eSpark-Consulting-Group/xponent-tech-sleep-enhancer-hw/README.md

# xponenttech-sleepenhancer-hardware
To develop a basic microphone PCB for the client
