eSpark-Consulting-Group/xponent-tech-sleep-enhancer-hw/Design Files/Xponent-tech/Deliverables/BOM/Client-BOM-Xponent-tech.xlsx

Sheet: 1 Board
 |  | Component list |  | Bill of Materials for Project [Xponent-tech]
 |  | Source Data From: |  | Xponent-tech
 |  | Project: |  | Xponent-tech
 |  | Variant: |  | None
# | Item Type | Designator | Description | Footprint | Manufacturer Part Number | Manufacturer | Value | Quantity | Total Cost (1 Boards) | Remarks
1 | Capacitor | C1, C2, C10, C13 | CAP CER 0.1UF 50V X7R 0603 | CAP-0603 | CL10B104KB8NNNL | Samsung | 0.1uF | 4 | $0.6500
2 | Capacitor | C3, C5, C17, C20 | CAP CER 1UF 50V X7R 0603 | Cap-0603 | UMK107AB7105KA-T | Taiyo Yuden | 1uF | 4 | $0.7000
3 | Capacitor | C4 | CAP CER 47PF 100V NPO 0603 | Cap-0603 | AC0603JRNPO0BN470 | Yageo | 47pF | 1 | $0.3000
4 | Capacitor | C6 | CAP CER 0.047UF 50V X8R 0603 | Cap-0603 | FN18X473K500PBG | TDK | 47nF | 1 | $0.3000
5 | Capacitor | C7 | CAP CER 4700PF 50V C0G/NPO 0603 | Cap-0603 | CC0603JRNPO9BN472 | Yageo | 4.7nF | 1 | $0.3000
6 | Capacitor | C8, C18 | CAP ALUM 10uF 25V SMD | Custom | RVT1E100M0405 | ROQANG | 10uF | 2 | $1.2580
7 | Capacitor | C9 | CAP CER 0.022UF 100V X7R 0603 | Cap-0603 | CC0603KRX7R0BB223 | TDK | 22nF | 1 | $0.3500
8 | Capacitor | C11 | 100V 4.2nF X7R ±10% 0402 Multilayer Ceramic Capacitors MLCC - SMD/SMT ROHS | Cap-0402 | GCM155R72A472KA01D | Murata Electronics | 4.2nF | 1 | $0.2500
9 | Capacitor | C12 | CAP CER 1200PF 25V X7R 0402 | Cap-0402 | 0402B122K250CT | KEMET | 1.2nF | 1 | $0.2500
10 | Capacitor | C14, C15 | 50V 100nF C0G ±1% 1206 Multilayer Ceramic Capacitors MLCC - SMD/SMT ROHS | Cap-1206 | GRM31C5C1H104FA01L | Murata Electronics | 0.1uF | 2 | $0.4000
11 | Capacitor | C16 | 50V 200nF ±10% 0805 Multilayer Ceramic Capacitors MLCC - SMD/SMT ROHS | Cap-0805 | NL0805B204K500CPBN | HUI JU | 0.2uF | 1 | $0.2500
12 | Capacitor | C19 | CAP CER 4.7UF 50V X7R 1206 | Cap-1206 | GRM31CR61E476ME44L | TDK | 4.7uF | 1 | $0.3000
13 | Capacitor | C21 | CAP CER 33PF 25V C0G/NP0 0402 | Cap-0402 | 0402N330K250CT | Murata | 33pF | 1 | $0.2000
14 | Capacitor | C22 | CAP, 2.2µF, 35V, 10%, X5R, 0603 | Cap-0603 | GRM188R6YA225KA12D | Murata | 2.2uF | 1 | $0.3500
15 | Header | J1 | KK 254 Breakaway Header, Vertical, 2 Circuits, Tin (Sn) Plating, Mating Pin Length 6.09mm | HDR1X2_ | 22-28-4020 | Molex | - | 1 | $0.3000
16 | Header | J2 | 3A Straight Square Pins -40℃~+105℃ 3 2.54mm Black 1x3P Plugin,P=2.54mm Pin Headers ROHS | HDR1X3_ | C49257 | BOOMELE | - | 1 | $0.3500
17 | Microphone | MK1 | 1.5V~3.6V Omnidirectional 120uA -42dB 400Ω 59dB SMD-4P,1.9x2.8mm MEMS Microphones ROHS | Custom | ZTS6117 | Zilltek | - | 1 | $1.7200
18 | Potentiometer | R1, R10 | Trimmer, Cermet, Rest 100 Kilohms, PCB, 25 Turns, Pwr-Rtg 0.5W, 3296 Series | Custom | 3296W-1-104 | BOCHEN(Chengdu Guosheng Tech) | 100k | 2 | $2.5800
19 | Resistor | R2, R3, R4, R7, R8, R9, R48, R52, R65, R66, R68, R69, R70 | RES SMD 10K OHM 0.1% 1/10W 0603 | Res-0603 | RT0603BRD0710KL | Yageo | 10K | 13 | $0.8800
20 | Potentiometer | R5 | ±25% 500kΩ SMD Variable Resistors/Potentiometers ROHS | Custom | VG039NCHXTB504 | HDK | 500k | 1 | $0.7200
21 | Resistor | R6, R42, R43, R58 | RES SMD 1K OHM 0.1% 1/10W 0603 | Res-0603 | RT0603BRD071KL | Yageo | 1K | 4 | $0.4700
22 | Resistor | R11, R12 | RES SMD 3.3K OHM 0.1% 1/10W 0603 | Res-0603 | RT0603BRD073K3L | Yageo | 3.3k | 2 | $0.4000
23 | Resistor | R13 | RES SMD 22K OHM 0.1% 1/10W 0603 | Res-0603 | RT0603BRD0722KL | Yageo | 22K | 1 | $0.2500
24 | Potentiometer | R14 | Res Cermet Trimmer 500K Ohm 10% 1/2W 25(Elec)Turn | Custom | 3296W-1-504 | BOCHEN(Chengdu Guosheng Tech) | 500k | 1 | $2.4250
25 | Resistor | R15, R16 | RES SMD 1.8K OHM 0.1% 1/10W 0603 | Res-0603 | RT0603BRD071K8L | Yageo | 1.8K | 2 | $0.4500
26 | Resistor | R17 | RES SMD 270 OHM 0.1% 1/10W 0603 | Res-0603 | RT0603BRE07270RL | Yageo | 270R | 1 | $0.3000
27 | Resistor | R18, R19 | ±1% 80kΩ 0603 Chip Resistor - Surface Mount ROHS | Res-0603 | ARG03FTC8002N | Viking Tech | 80K | 2 | $0.3800
28 | Resistor | R20, R21, R49 | ±0.1% 40kΩ 0805 Chip Resistor - Surface Mount ROHS | RES-0805 | AR05BTC4002 | Viking Tech | 40K | 3 | $0.5800
29 | Resistor | R22, R23 | ±25ppm/℃ ±0.1% 27kΩ 0402 Chip Resistor - Surface Mount ROHS | Res-0402 | ARG02BTC2702 | Viking Tech | 27K | 2 | $0.6000
30 | Resistor | R24, R25, R50 | 100mW ±25ppm/℃ ±0.1% 20kΩ 0603 Chip Resistor - Surface Mount ROHS | Res-0603 | AR03BTCX2002 | Viking Tech | 20K | 3 | $0.7000
31 | Resistor | R26, R27 | RES 16K OHM 0.5% 1/10W 0603 | Res-0603 | RC0603DR-0716KL | Yageo | 16K | 2 | $0.3700
32 | Resistor | R28, R29, R53 | RES SMD 8.2K OHM 0.1% 1/10W 0603 | Res-0603 | RT0603BRD078K2L | Yageo | 8.2K | 3 | $0.4900
33 | Resistor | R30, R31, R55 | RES 4.02K OHM 1% 1/16W 0402 | Res-0402 | RC0402FR-074K02L | Yageo | 4.02K | 3 | $0.7000
34 | Resistor | R32, R33 | RES 2.7K OHM 1% 1/10W 0603 | Res-0603 | RC0603FR-072K7L | Yageo | 2.7K | 2 | $0.2500
35 | Resistor | R34, R35, R56 | 100mW ±25ppm/℃ ±0.1% 2kΩ 0603 Chip Resistor - Surface Mount ROHS | Res-0603 | AR03BTCX2001 | Viking Tech | 2K | 3 | $0.4500
36 | Resistor | R36, R37 | RES SMD 1.6K OHM 0.1% 1/16W 0402 | Res-0402 | RT0402BRD071K6L | Yageo | 1.6K | 2 | $0.3600
37 | Resistor | R38, R39, R57 | 100mW ±25ppm/℃ ±0.1% 1.3kΩ 0603 Chip Resistor - Surface Mount ROHS | Res-0603 | AR03BTCX1301 | Viking Tech | 1.3K | 3 | $0.9000
38 | Resistor | R40, R41 | RES SMD 1.1K OHM 0.1% 1/10W 0603 | Res-0603 | RT0603BRD071K1L | Yageo | 1.1K | 2 | $0.5500
39 | Resistor | R44, R45 | 125mW Thin Film Resistor 150V ±25ppm/℃ ±0.1% -55℃~+155℃ 900Ω 0805 Chip Resistor - Surface Mount ROHS | RES-0805 | ARG05BTC9000N | Viking Tech | 900R | 2 | $0.6500
40 | Resistor | R46, R47, R59 | RES SMD 806 OHM 0.1% 1/16W 0402 | Res-0402 | RT0402BRD07806RL | Yageo | 806R | 3 | $0.8500
41 | Resistor | R51 | RES SMD 13.3KOHM 0.1% 1/10W 0603 | Res-0603 | RT0603BRD0713K3L | Yageo | 13.3K | 1 | $0.2000
42 | Resistor | R54 | 125mW Thick Film Resistors 150V ±100ppm/℃ ±1% -55℃~+155℃ 98kΩ 0805 Chip Resistor - Surface Mount ROHS | RES-0805 | FRC0805F9802TS | FOJAN | 98K | 1 | $0.4000
43 | Resistor | R60 | RES SMD 649 OHM 0.1% 1/8W 0805 | RES-0805 | RT0805BRD07649RL | Yageo | 649R | 1 | $0.3000
44 | Resistor | R61 | 62.5mW Thin Film Resistor 50V ±25ppm/℃ ±0.1% -55℃~+155℃ 549Ω 0402 Chip Resistor - Surface Mount ROHS | Res-0402 | ARG02BTC5490 | Viking Tech | 549R | 1 | $0.2500
45 | Resistor | R62 | 125mW Thin Film Resistor 150V ±25ppm/℃ ±0.1% -55℃~+155℃ 500Ω 0805 Chip Resistor - Surface Mount ROHS | RES-0805 | ARG05BTC5000 | Viking Tech | 500R | 1 | $0.2500
46 | Resistor | R63 | RES SMD 453 OHM 0.1% 1/16W 0402 | Res-0402 | RT0402BRD07453RL | Yageo | 453R | 1 | $0.2500
47 | Resistor | R64 | 100mW Thin Film Resistor 75V ±25ppm/℃ ±0.1% -55℃~+155℃ 402Ω 0603 Chip Resistor - Surface Mount ROHS | Res-0603 | ARG03BTC4020 | Viking Tech | 402R | 1 | $0.2500
48 | Potentiometer | R67 | TRIMMER 100K OHM 0.1W J LEAD TOP | Custom | TC33X-2-104E | Bourns | 100k | 1 | $0.8000
49 | Resistor | R71, R72 | RES SMD 47K OHM 0.1% 1/10W 0603 | Res-0603 | RT0603BRD0747KL | Yageo | 47K | 2 | $0.4200
50 | Solder Bridge | ~~SB1, SB2~~ | ~~Solder Bridge ON~~ | ~~Custom~~ | ~~Solder Bridge~~ | ~~-~~ | ~~-~~ | ~~2~~ | ~~-~~
51 | Switch | SW1, SW2, SW3, SW4, SW5, SW6, SW7, SW8, SW9 | Gull Wing SPST 24V 25mA Black -20℃~+70℃ 3000 Flat dial, raised type 2.54mm 5 SMD-10P,6x12.6mm DIP Switches ROHS | Custom | DSIC05LS-P | XKB Connectivity | - | 9 | $13.6000
52 | IC | U1, U2, U3 | General Purpose Amplifier 2 Circuit 8-SO | SOIC-8 | LM2904DT | STMicroelectronics | - | 3 | $3.8000
 |  |  |  |  |  | Total Component Cost |  |  | $45.05

Sheet: 2 Boards
 |  | Component list |  | Bill of Materials for Project [Xponent-tech]
 |  | Source Data From: |  | Xponent-tech
 |  | Project: |  | Xponent-tech
 |  | Variant: |  | None
# | Item Type | Designator | Description | Footprint | Manufacturer Part Number | Manufacturer | Value | Quantity Per Board | Quantity (2 Boards) | Total Cost (2 Boards) | Remarks
1 | Capacitor | C1, C2, C10, C13 | CAP CER 0.1UF 50V X7R 0603 | CAP-0603 | CL10B104KB8NNNL | Samsung | 0.1uF | 4 | 8 | $0.8000
2 | Capacitor | C3, C5, C17, C20 | CAP CER 1UF 50V X7R 0603 | Cap-0603 | UMK107AB7105KA-T | Taiyo Yuden | 1uF | 4 | 8 | $0.7500
3 | Capacitor | C4 | CAP CER 47PF 100V NPO 0603 | Cap-0603 | AC0603JRNPO0BN470 | Yageo | 47pF | 1 | 2 | $0.3000
4 | Capacitor | C6 | CAP CER 0.047UF 50V X8R 0603 | Cap-0603 | FN18X473K500PBG | TDK | 47nF | 1 | 2 | $0.3000
5 | Capacitor | C7 | CAP CER 4700PF 50V C0G/NPO 0603 | Cap-0603 | CC0603JRNPO9BN472 | Yageo | 4.7nF | 1 | 2 | $0.3000
6 | Capacitor | C8, C18 | CAP ALUM 10uF 25V SMD | Custom | RVT1E100M0405 | ROQANG | 10uF | 2 | 4 | $2.4500
7 | Capacitor | C9 | CAP CER 0.022UF 100V X7R 0603 | Cap-0603 | CC0603KRX7R0BB223 | TDK | 22nF | 1 | 2 | $0.3500
8 | Capacitor | C11 | 100V 4.2nF X7R ±10% 0402 Multilayer Ceramic Capacitors MLCC - SMD/SMT ROHS | Cap-0402 | GCM155R72A472KA01D | Murata Electronics | 4.2nF | 1 | 2 | $0.3500
9 | Capacitor | C12 | CAP CER 1200PF 25V X7R 0402 | Cap-0402 | 0402B122K250CT | KEMET | 1.2nF | 1 | 2 | $0.3500
10 | Capacitor | C14, C15 | 50V 100nF C0G ±1% 1206 Multilayer Ceramic Capacitors MLCC - SMD/SMT ROHS | Cap-1206 | GRM31C5C1H104FA01L | Murata Electronics | 0.1uF | 2 | 4 | $0.6500
11 | Capacitor | C16 | 50V 200nF ±10% 0805 Multilayer Ceramic Capacitors MLCC - SMD/SMT ROHS | Cap-0805 | NL0805B204K500CPBN | HUI JU | 0.2uF | 1 | 2 | $0.2500
12 | Capacitor | C19 | CAP CER 4.7UF 50V X7R 1206 | Cap-1206 | GRM31CR61E476ME44L | TDK | 4.7uF | 1 | 2 | $0.3000
13 | Capacitor | C21 | CAP CER 33PF 25V C0G/NP0 0402 | Cap-0402 | 0402N330K250CT | Murata | 33pF | 1 | 2 | $0.3000
14 | Capacitor | C22 | CAP, 2.2µF, 35V, 10%, X5R, 0603 | Cap-0603 | GRM188R6YA225KA12D | Murata | 2.2uF | 1 | 2 | $0.4000
15 | Header | J1 | KK 254 Breakaway Header, Vertical, 2 Circuits, Tin (Sn) Plating, Mating Pin Length 6.09mm | HDR1X2_ | 22-28-4020 | Molex | - | 1 | 2 | $0.4800
16 | Header | J2 | 3A Straight Square Pins -40℃~+105℃ 3 2.54mm Black 1x3P Plugin,P=2.54mm Pin Headers ROHS | HDR1X3_ | C49257 | BOOMELE | - | 1 | 2 | $0.5200
17 | Microphone | MK1 | 1.5V~3.6V Omnidirectional 120uA -42dB 400Ω 59dB SMD-4P,1.9x2.8mm MEMS Microphones ROHS | Custom | ZTS6117 | Zilltek | - | 1 | 2 | $2.3200
18 | Potentiometer | R1, R10 | Trimmer, Cermet, Rest 100 Kilohms, PCB, 25 Turns, Pwr-Rtg 0.5W, 3296 Series | Custom | 3296W-1-104 | BOCHEN(Chengdu Guosheng Tech) | 100k | 2 | 4 | $3.8000
19 | Resistor | R2, R3, R4, R7, R8, R9, R48, R52, R65, R66, R68, R69, R70 | RES SMD 10K OHM 0.1% 1/10W 0603 | Res-0603 | RT0603BRD0710KL | Yageo | 10K | 13 | 26 | $1.2000
20 | Potentiometer | R5 | ±25% 500kΩ SMD Variable Resistors/Potentiometers ROHS | Custom | VG039NCHXTB504 | HDK | 500k | 1 | 2 | $0.3500
21 | Resistor | R6, R42, R43, R58 | RES SMD 1K OHM 0.1% 1/10W 0603 | Res-0603 | RT0603BRD071KL | Yageo | 1K | 4 | 8 | $0.6500
22 | Resistor | R11, R12 | RES SMD 3.3K OHM 0.1% 1/10W 0603 | Res-0603 | RT0603BRD073K3L | Yageo | 3.3k | 2 | 4 | $0.4200
23 | Resistor | R13 | RES SMD 22K OHM 0.1% 1/10W 0603 | Res-0603 | RT0603BRD0722KL | Yageo | 22K | 1 | 2 | $0.4000
24 | Potentiometer | R14 | Res Cermet Trimmer 500K Ohm 10% 1/2W 25(Elec)Turn | Custom | 3296W-1-504 | BOCHEN(Chengdu Guosheng Tech) | 500k | 1 | 2 | $3.7600
25 | Resistor | R15, R16 | RES SMD 1.8K OHM 0.1% 1/10W 0603 | Res-0603 | RT0603BRD071K8L | Yageo | 1.8K | 2 | 4 | $0.7000
26 | Resistor | R17 | RES SMD 270 OHM 0.1% 1/10W 0603 | Res-0603 | RT0603BRE07270RL | Yageo | 270R | 1 | 2 | $0.4800
27 | Resistor | R18, R19 | ±1% 80kΩ 0603 Chip Resistor - Surface Mount ROHS | Res-0603 | ARG03FTC8002N | Viking Tech | 80K | 2 | 4 | $0.9000
28 | Resistor | R20, R21, R49 | ±0.1% 40kΩ 0805 Chip Resistor - Surface Mount ROHS | RES-0805 | AR05BTC4002 | Viking Tech | 40K | 3 | 6 | $0.7500
29 | Resistor | R22, R23 | ±25ppm/℃ ±0.1% 27kΩ 0402 Chip Resistor - Surface Mount ROHS | Res-0402 | ARG02BTC2702 | Viking Tech | 27K | 2 | 4 | $0.5600
30 | Resistor | R24, R25, R50 | 100mW ±25ppm/℃ ±0.1% 20kΩ 0603 Chip Resistor - Surface Mount ROHS | Res-0603 | AR03BTCX2002 | Viking Tech | 20K | 3 | 6 | $0.6700
31 | Resistor | R26, R27 | RES 16K OHM 0.5% 1/10W 0603 | Res-0603 | RC0603DR-0716KL | Yageo | 16K | 2 | 4 | $0.3800
32 | Resistor | R28, R29, R53 | RES SMD 8.2K OHM 0.1% 1/10W 0603 | Res-0603 | RT0603BRD078K2L | Yageo | 8.2K | 3 | 6 | $0.7800
33 | Resistor | R30, R31, R55 | RES 4.02K OHM 1% 1/16W 0402 | Res-0402 | RC0402FR-074K02L | Yageo | 4.02K | 3 | 6 | $0.6900
34 | Resistor | R32, R33 | RES 2.7K OHM 1% 1/10W 0603 | Res-0603 | RC0603FR-072K7L | Yageo | 2.7K | 2 | 4 | $0.6000
35 | Resistor | R34, R35, R56 | 100mW ±25ppm/℃ ±0.1% 2kΩ 0603 Chip Resistor - Surface Mount ROHS | Res-0603 | AR03BTCX2001 | Viking Tech | 2K | 3 | 6 | $0.7000
36 | Resistor | R36, R37 | RES SMD 1.6K OHM 0.1% 1/16W 0402 | Res-0402 | RT0402BRD071K6L | Yageo | 1.6K | 2 | 4 | $0.4500
37 | Resistor | R38, R39, R57 | 100mW ±25ppm/℃ ±0.1% 1.3kΩ 0603 Chip Resistor - Surface Mount ROHS | Res-0603 | AR03BTCX1301 | Viking Tech | 1.3K | 3 | 6 | $0.5000
38 | Resistor | R40, R41 | RES SMD 1.1K OHM 0.1% 1/10W 0603 | Res-0603 | RT0603BRD071K1L | Yageo | 1.1K | 2 | 4 | $0.4700
39 | Resistor | R44, R45 | 125mW Thin Film Resistor 150V ±25ppm/℃ ±0.1% -55℃~+155℃ 900Ω 0805 Chip Resistor - Surface Mount ROHS | RES-0805 | ARG05BTC9000N | Viking Tech | 900R | 2 | 4 | $0.6000
40 | Resistor | R46, R47, R59 | RES SMD 806 OHM 0.1% 1/16W 0402 | Res-0402 | RT0402BRD07806RL | Yageo | 806R | 3 | 6 | $0.8000
41 | Resistor | R51 | RES SMD 13.3KOHM 0.1% 1/10W 0603 | Res-0603 | RT0603BRD0713K3L | Yageo | 13.3K | 1 | 2 | $0.4500
42 | Resistor | R54 | 125mW Thick Film Resistors 150V ±100ppm/℃ ±1% -55℃~+155℃ 98kΩ 0805 Chip Resistor - Surface Mount ROHS | RES-0805 | FRC0805F9802TS | FOJAN | 98K | 1 | 2 | $0.3700
43 | Resistor | R60 | RES SMD 649 OHM 0.1% 1/8W 0805 | RES-0805 | RT0805BRD07649RL | Yageo | 649R | 1 | 2 | $0.4000
44 | Resistor | R61 | 62.5mW Thin Film Resistor 50V ±25ppm/℃ ±0.1% -55℃~+155℃ 549Ω 0402 Chip Resistor - Surface Mount ROHS | Res-0402 | ARG02BTC5490 | Viking Tech | 549R | 1 | 2 | $0.3300
45 | Resistor | R62 | 125mW Thin Film Resistor 150V ±25ppm/℃ ±0.1% -55℃~+155℃ 500Ω 0805 Chip Resistor - Surface Mount ROHS | RES-0805 | ARG05BTC5000 | Viking Tech | 500R | 1 | 2 | $0.3000
46 | Resistor | R63 | RES SMD 453 OHM 0.1% 1/16W 0402 | Res-0402 | RT0402BRD07453RL | Yageo | 453R | 1 | 2 | $0.2500
47 | Resistor | R64 | 100mW Thin Film Resistor 75V ±25ppm/℃ ±0.1% -55℃~+155℃ 402Ω 0603 Chip Resistor - Surface Mount ROHS | Res-0603 | ARG03BTC4020 | Viking Tech | 402R | 1 | 2 | $0.4400
48 | Potentiometer | R67 | TRIMMER 100K OHM 0.1W J LEAD TOP | Custom | TC33X-2-104E | Bourns | 100k | 1 | 2 | $0.1300
49 | Resistor | R71, R72 | RES SMD 47K OHM 0.1% 1/10W 0603 | Res-0603 | RT0603BRD0747KL | Yageo | 47K | 2 | 4 | $0.4500
50 | Solder Bridge | ~~SB1, SB2~~ | ~~Solder Bridge ON~~ | ~~Custom~~ | ~~Solder Bridge~~ | ~~-~~ | ~~-~~ | ~~2~~ | 4 | -
51 | Switch | SW1, SW2, SW3, SW4, SW5, SW6, SW7, SW8, SW9 | Gull Wing SPST 24V 25mA Black -20℃~+70℃ 3000 Flat dial, raised type 2.54mm 5 SMD-10P,6x12.6mm DIP Switches ROHS | Custom | DSIC05LS-P | XKB Connectivity | - | 9 | 18 | $15.7000
52 | IC | U1, U2, U3 | General Purpose Amplifier 2 Circuit 8-SO | SOIC-8 | LM2904DT | STMicroelectronics | - | 3 | 6 | $5.4000
 |  |  |  |  |  |  | Total Component Cost |  |  | $56.00
 |  |  |  |  |  |  | Single Board Cost |  |  | $28.00

Sheet: 5 Boards
 |  | Component list |  | Bill of Materials for Project [Xponent-tech]
 |  | Source Data From: |  | Xponent-tech
 |  | Project: |  | Xponent-tech
 |  | Variant: |  | None
# | Item Type | Designator | Description | Footprint | Manufacturer Part Number | Manufacturer | Value | Quantity Per Board | Quantity (5 Boards) | Total Cost(5 Boards) | Remarks
1 | Capacitor | C1, C2, C10, C13 | CAP CER 0.1UF 50V X7R 0603 | CAP-0603 | CL10B104KB8NNNL | Samsung | 0.1uF | 4 | 20 | $0.8800
2 | Capacitor | C3, C5, C17, C20 | CAP CER 1UF 50V X7R 0603 | Cap-0603 | UMK107AB7105KA-T | Taiyo Yuden | 1uF | 4 | 20 | $0.7800
3 | Capacitor | C4 | CAP CER 47PF 100V NPO 0603 | Cap-0603 | AC0603JRNPO0BN470 | Yageo | 47pF | 1 | 5 | $0.6500
4 | Capacitor | C6 | CAP CER 0.047UF 50V X8R 0603 | Cap-0603 | FN18X473K500PBG | TDK | 47nF | 1 | 5 | $0.7000
5 | Capacitor | C7 | CAP CER 4700PF 50V C0G/NPO 0603 | Cap-0603 | CC0603JRNPO9BN472 | Yageo | 4.7nF | 1 | 5 | $0.6900
6 | Capacitor | C8, C18 | CAP ALUM 10uF 25V SMD | Custom | RVT1E100M0405 | ROQANG | 10uF | 2 | 10 | $4.7000
7 | Capacitor | C9 | CAP CER 0.022UF 100V X7R 0603 | Cap-0603 | CC0603KRX7R0BB223 | TDK | 22nF | 1 | 5 | $0.7000
8 | Capacitor | C11 | 100V 4.2nF X7R ±10% 0402 Multilayer Ceramic Capacitors MLCC - SMD/SMT ROHS | Cap-0402 | GCM155R72A472KA01D | Murata Electronics | 4.2nF | 1 | 5 | $0.5600
9 | Capacitor | C12 | CAP CER 1200PF 25V X7R 0402 | Cap-0402 | 0402B122K250CT | KEMET | 1.2nF | 1 | 5 | $0.7700
10 | Capacitor | C14, C15 | 50V 100nF C0G ±1% 1206 Multilayer Ceramic Capacitors MLCC - SMD/SMT ROHS | Cap-1206 | GRM31C5C1H104FA01L | Murata Electronics | 0.1uF | 2 | 10 | $0.6600
11 | Capacitor | C16 | 50V 200nF ±10% 0805 Multilayer Ceramic Capacitors MLCC - SMD/SMT ROHS | Cap-0805 | NL0805B204K500CPBN | HUI JU | 0.2uF | 1 | 5 | $0.7800
12 | Capacitor | C19 | CAP CER 4.7UF 50V X7R 1206 | Cap-1206 | GRM31CR61E476ME44L | TDK | 4.7uF | 1 | 5 | $0.6750
13 | Capacitor | C21 | CAP CER 33PF 25V C0G/NP0 0402 | Cap-0402 | 0402N330K250CT | Murata | 33pF | 1 | 5 | $0.7000
14 | Capacitor | C22 | CAP, 2.2µF, 35V, 10%, X5R, 0603 | Cap-0603 | GRM188R6YA225KA12D | Murata | 2.2uF | 1 | 5 | $0.8800
15 | Header | J1 | KK 254 Breakaway Header, Vertical, 2 Circuits, Tin (Sn) Plating, Mating Pin Length 6.09mm | HDR1X2_ | 22-28-4020 | Molex | - | 1 | 5 | $0.8000
16 | Header | J2 | 3A Straight Square Pins -40℃~+105℃ 3 2.54mm Black 1x3P Plugin,P=2.54mm Pin Headers ROHS | HDR1X3_ | C49257 | BOOMELE | - | 1 | 5 | $0.9500
17 | Microphone | MK1 | 1.5V~3.6V Omnidirectional 120uA -42dB 400Ω 59dB SMD-4P,1.9x2.8mm MEMS Microphones ROHS | Custom | ZTS6117 | Zilltek | - | 1 | 5 | $3.8500
18 | Potentiometer | R1, R10 | Trimmer, Cermet, Rest 100 Kilohms, PCB, 25 Turns, Pwr-Rtg 0.5W, 3296 Series | Custom | 3296W-1-104 | BOCHEN(Chengdu Guosheng Tech) | 100k | 2 | 10 | $5.5070
19 | Resistor | R2, R3, R4, R7, R8, R9, R48, R52, R65, R66, R68, R69, R70 | RES SMD 10K OHM 0.1% 1/10W 0603 | Res-0603 | RT0603BRD0710KL | Yageo | 10K | 13 | 65 | $1.2000
20 | Potentiometer | R5 | ±25% 500kΩ SMD Variable Resistors/Potentiometers ROHS | Custom | VG039NCHXTB504 | HDK | 500k | 1 | 5 | $0.7600
21 | Resistor | R6, R42, R43, R58 | RES SMD 1K OHM 0.1% 1/10W 0603 | Res-0603 | RT0603BRD071KL | Yageo | 1K | 4 | 20 | $1.0000
22 | Resistor | R11, R12 | RES SMD 3.3K OHM 0.1% 1/10W 0603 | Res-0603 | RT0603BRD073K3L | Yageo | 3.3k | 2 | 10 | $0.6500
23 | Resistor | R13 | RES SMD 22K OHM 0.1% 1/10W 0603 | Res-0603 | RT0603BRD0722KL | Yageo | 22K | 1 | 5 | $0.7500
 | Potentiometer | R14 | Res Cermet Trimmer 500K Ohm 10% 1/2W 25(Elec)Turn | Custom | 3296W-1-504 | BOCHEN(Chengdu Guosheng Tech) | 500k | 1 | 5 | $4.3700
25 | Resistor | R15, R16 | RES SMD 1.8K OHM 0.1% 1/10W 0603 | Res-0603 | RT0603BRD071K8L | Yageo | 1.8K | 2 | 10 | $0.7500
26 | Resistor | R17 | RES SMD 270 OHM 0.1% 1/10W 0603 | Res-0603 | RT0603BRE07270RL | Yageo | 270R | 1 | 5 | $0.6600
27 | Resistor | R18, R19 | ±1% 80kΩ 0603 Chip Resistor - Surface Mount ROHS | Res-0603 | ARG03FTC8002N | Viking Tech | 80K | 2 | 10 | $0.7800
28 | Resistor | R20, R21, R49 | ±0.1% 40kΩ 0805 Chip Resistor - Surface Mount ROHS | RES-0805 | AR05BTC4002 | Viking Tech | 40K | 3 | 15 | $0.9000
29 | Resistor | R22, R23 | ±25ppm/℃ ±0.1% 27kΩ 0402 Chip Resistor - Surface Mount ROHS | Res-0402 | ARG02BTC2702 | Viking Tech | 27K | 2 | 10 | $0.7500
30 | Resistor | R24, R25, R50 | 100mW ±25ppm/℃ ±0.1% 20kΩ 0603 Chip Resistor - Surface Mount ROHS | Res-0603 | AR03BTCX2002 | Viking Tech | 20K | 3 | 15 | $0.8500
31 | Resistor | R26, R27 | RES 16K OHM 0.5% 1/10W 0603 | Res-0603 | RC0603DR-0716KL | Yageo | 16K | 2 | 10 | $0.7700
32 | Resistor | R28, R29, R53 | RES SMD 8.2K OHM 0.1% 1/10W 0603 | Res-0603 | RT0603BRD078K2L | Yageo | 8.2K | 3 | 15 | $0.9800
33 | Resistor | R30, R31, R55 | RES 4.02K OHM 1% 1/16W 0402 | Res-0402 | RC0402FR-074K02L | Yageo | 4.02K | 3 | 15 | $0.7630
34 | Resistor | R32, R33 | RES 2.7K OHM 1% 1/10W 0603 | Res-0603 | RC0603FR-072K7L | Yageo | 2.7K | 2 | 10 | $0.8000
35 | Resistor | R34, R35, R56 | 100mW ±25ppm/℃ ±0.1% 2kΩ 0603 Chip Resistor - Surface Mount ROHS | Res-0603 | AR03BTCX2001 | Viking Tech | 2K | 3 | 15 | $0.9000
36 | Resistor | R36, R37 | RES SMD 1.6K OHM 0.1% 1/16W 0402 | Res-0402 | RT0402BRD071K6L | Yageo | 1.6K | 2 | 10 | $0.7000
37 | Resistor | R38, R39, R57 | 100mW ±25ppm/℃ ±0.1% 1.3kΩ 0603 Chip Resistor - Surface Mount ROHS | Res-0603 | AR03BTCX1301 | Viking Tech | 1.3K | 3 | 15 | $0.8100
38 | Resistor | R40, R41 | RES SMD 1.1K OHM 0.1% 1/10W 0603 | Res-0603 | RT0603BRD071K1L | Yageo | 1.1K | 2 | 10 | $0.7500
39 | Resistor | R44, R45 | 125mW Thin Film Resistor 150V ±25ppm/℃ ±0.1% -55℃~+155℃ 900Ω 0805 Chip Resistor - Surface Mount ROHS | RES-0805 | ARG05BTC9000N | Viking Tech | 900R | 2 | 10 | $0.8800
40 | Resistor | R46, R47, R59 | RES SMD 806 OHM 0.1% 1/16W 0402 | Res-0402 | RT0402BRD07806RL | Yageo | 806R | 3 | 15 | $0.9600
41 | Resistor | R51 | RES SMD 13.3KOHM 0.1% 1/10W 0603 | Res-0603 | RT0603BRD0713K3L | Yageo | 13.3K | 1 | 5 | $0.4800
42 | Resistor | R54 | 125mW Thick Film Resistors 150V ±100ppm/℃ ±1% -55℃~+155℃ 98kΩ 0805 Chip Resistor - Surface Mount ROHS | RES-0805 | FRC0805F9802TS | FOJAN | 98K | 1 | 5 | $0.5500
43 | Resistor | R60 | RES SMD 649 OHM 0.1% 1/8W 0805 | RES-0805 | RT0805BRD07649RL | Yageo | 649R | 1 | 5 | $0.8800
44 | Resistor | R61 | 62.5mW Thin Film Resistor 50V ±25ppm/℃ ±0.1% -55℃~+155℃ 549Ω 0402 Chip Resistor - Surface Mount ROHS | Res-0402 | ARG02BTC5490 | Viking Tech | 549R | 1 | 5 | $0.4200
45 | Resistor | R62 | 125mW Thin Film Resistor 150V ±25ppm/℃ ±0.1% -55℃~+155℃ 500Ω 0805 Chip Resistor - Surface Mount ROHS | RES-0805 | ARG05BTC5000 | Viking Tech | 500R | 1 | 5 | $0.5300
46 | Resistor | R63 | RES SMD 453 OHM 0.1% 1/16W 0402 | Res-0402 | RT0402BRD07453RL | Yageo | 453R | 1 | 5 | $0.6800
47 | Resistor | R64 | 100mW Thin Film Resistor 75V ±25ppm/℃ ±0.1% -55℃~+155℃ 402Ω 0603 Chip Resistor - Surface Mount ROHS | Res-0603 | ARG03BTC4020 | Viking Tech | 402R | 1 | 5 | $0.7400
48 | Potentiometer | R67 | TRIMMER 100K OHM 0.1W J LEAD TOP | Custom | TC33X-2-104E | Bourns | 100k | 1 | 5 | $2.3600
49 | Resistor | R71, R72 | RES SMD 47K OHM 0.1% 1/10W 0603 | Res-0603 | RT0603BRD0747KL | Yageo | 47K | 2 | 10 | $0.8800
50 | Solder Bridge | ~~SB1, SB2~~ | ~~Solder Bridge ON~~ | ~~Custom~~ | ~~Solder Bridge~~ | ~~-~~ | ~~-~~ | ~~2~~ | ~~10~~ | ~~-~~
51 | Switch | SW1, SW2, SW3, SW4, SW5, SW6, SW7, SW8, SW9 | Gull Wing SPST 24V 25mA Black -20℃~+70℃ 3000 Flat dial, raised type 2.54mm 5 SMD-10P,6x12.6mm DIP Switches ROHS | Custom | DSIC05LS-P | XKB Connectivity | - | 9 | 45 | $29.5000
52 | IC | U1, U2, U3 | General Purpose Amplifier 2 Circuit 8-SO | SOIC-8 | LM2904DT | STMicroelectronics | - | 3 | 15 | $10.2000
 |  |  |  |  |  |  | Total Component Cost |  |  | $94.19
 |  |  |  |  |  |  | Single Board Cost |  |  | $18.84
