eSpark-Consulting-Group/xponent-tech-sleep-enhancer-hw/Design Files/Xponent-tech/Deliverables/BOM/eSpark-BOM-Xponent-tech.xlsx

Sheet: 1 Board
 |  | Component list |  | Bill of Materials for Project [Xponent-tech]
 |  | Source Data From: |  | Xponent-tech
 |  | Project: |  | Xponent-tech
 |  | Variant: |  | None
# | Item Type | Designator | Description | Footprint | Manufacturer Part Number | Manufacturer | Alternate Part Number | LCSC Part Number | Value | Quantity | MOQ (1 Boards) | Links | Unit Cost (1 Boards) | Total Cost (1 Boards) | Remarks | Reviewer Remarks
1 | Capacitor | C1, C2, C10, C13 | CAP CER 0.1UF 50V X7R 0603 | CAP-0603 | CL10B104KB8NNNL | Samsung | - | C913912 | 0.1uF | 4 | 100 | LCSC (https://www.lcsc.com/product-detail/Multilayer-Ceramic-Capacitors-MLCC-SMD-SMT_Samsung-Electro-Mechanics-CL10B104KB8NNNL_C913912.html) | $0.0060 | $0.6000
2 | Capacitor | C3, C5, C17, C20 | CAP CER 1UF 50V X7R 0603 | Cap-0603 | UMK107AB7105KA-T | Taiyo Yuden | - | C105174 | 1uF | 4 | 20 | LCSC (https://www.lcsc.com/product-detail/Multilayer-Ceramic-Capacitors-MLCC-SMD-SMT_Taiyo-Yuden-UMK107AB7105KA-T_C105174.html) | $0.0289 | $0.5780
3 | Capacitor | C4 | CAP CER 47PF 100V NPO 0603 | Cap-0603 | AC0603JRNPO0BN470 | Yageo | - | C389107 | 47pF | 1 | 50 | LCSC (https://www.lcsc.com/product-detail/Multilayer-Ceramic-Capacitors-MLCC-SMD-SMT_YAGEO-AC0603JRNPO0BN470_C389107.html) | $0.0085 | $0.4250
4 | Capacitor | C6 | CAP CER 0.047UF 50V X8R 0603 | Cap-0603 | ~~CGA3E2X8R1H473M080AA~~ | TDK | FN18X473K500PBG | C525277 | 47nF | 1 | 100 | LCSC (https://www.lcsc.com/product-detail/Multilayer-Ceramic-Capacitors-MLCC-SMD-SMT_PSA-Prosperity-Dielectrics-FN18X473K500PBG_C525277.html) | $0.0030 | $0.3000
5 | Capacitor | C7 | CAP CER 4700PF 50V C0G/NPO 0603 | Cap-0603 | CC0603JRNPO9BN472 | Yageo | - | C576818 | 4.7nF | 1 | 20 | LCSC (https://www.lcsc.com/product-detail/Multilayer-Ceramic-Capacitors-MLCC-SMD-SMT_YAGEO-CC0603JRNPO9BN472_C576818.html) | $0.0217 | $0.4340
6 | Capacitor | C8, C18 | CAP ALUM 10uF 25V SMD | Custom | RVT1E100M0405 | ROQANG | - | C970655 | 10uF | 2 | 20 | LCSC (https://www.lcsc.com/product-detail/Aluminum-Electrolytic-Capacitors-SMD_DMBJ-RVT1E100M0405_C970655.html) | $0.0279 | $0.5580
7 | Capacitor | C9 | CAP CER 0.022UF 100V X7R 0603 | Cap-0603 | ~~CGA3E2X7R2A223K080AA~~ | TDK | CC0603KRX7R0BB223 | C313105 | 22nF | 1 | 50 | LCSC (https://www.lcsc.com/product-detail/Multilayer-Ceramic-Capacitors-MLCC-SMD-SMT_YAGEO-CC0603KRX7R0BB223_C313105.html) | $0.0090 | $0.4500
8 | Capacitor | C11 | 100V 4.2nF X7R ±10% 0402 Multilayer Ceramic Capacitors MLCC - SMD/SMT ROHS | Cap-0402 | GCM155R72A472KA01D | Murata Electronics | - | C2980803 | 4.2nF | 1 | 50 | LCSC (https://www.lcsc.com/product-detail/Multilayer-Ceramic-Capacitors-MLCC-SMD-SMT_Murata-Electronics-GCM155R72A472KA01D_C2980803.html) | $0.0092 | $0.4600
9 | Capacitor | C12 | CAP CER 1200PF 25V X7R 0402 | Cap-0402 | ~~C0402C122K3RAC7867~~ | KEMET | 0402B122K250CT | C458850 | 1.2nF | 1 | 100 | LCSC (https://www.lcsc.com/product-detail/Multilayer-Ceramic-Capacitors-MLCC-SMD-SMT_Walsin-Tech-Corp-0402B122K250CT_C458850.html) | $0.0038 | $0.3800
10 | Capacitor | C14, C15 | 50V 100nF C0G ±1% 1206 Multilayer Ceramic Capacitors MLCC - SMD/SMT ROHS | Cap-1206 | GRM31C5C1H104FA01L | Murata Electronics | - | C2981728 | 0.1uF | 2 | 3 | LCSC (https://www.lcsc.com/product-detail/Multilayer-Ceramic-Capacitors-MLCC-SMD-SMT_Murata-Electronics-GRM31C5C1H104FA01L_C2981728.html) | $0.4137 | $1.2411
11 | Capacitor | C16 | 50V 200nF ±10% 0805 Multilayer Ceramic Capacitors MLCC - SMD/SMT ROHS | Cap-0805 | NL0805B204K500CPBN | HUI JU | - | C918135 | 0.2uF | 1 | 50 | LCSC (https://www.lcsc.com/product-detail/Multilayer-Ceramic-Capacitors-MLCC-SMD-SMT_HUI-JU-NL0805B204K500CPBN_C918135.html) | $0.0129 | $0.6450
12 | Capacitor | C19 | CAP CER 4.7UF 50V X7R 1206 | Cap-1206 | ~~C3216X7R1H475K160AC~~ | TDK | GRM31CR61E476ME44L | C403725 | 4.7uF | 1 | 2 | LCSC (https://www.lcsc.com/product-detail/Multilayer-Ceramic-Capacitors-MLCC-SMD-SMT_Murata-Electronics-GRM31CR61E476ME44L_C403725.html) | $0.3182 | $0.6364
13 | Capacitor | C21 | CAP CER 33PF 25V C0G/NP0 0402 | Cap-0402 | ~~GRM1555C1E330JA01D~~ | Murata | 0402N330K250CT | C387979 | 33pF | 1 | 50 | LCSC (https://www.lcsc.com/product-detail/Multilayer-Ceramic-Capacitors-MLCC-SMD-SMT_Walsin-Tech-Corp-0402N330K250CT_C387979.html) | $0.0051 | $0.2550
14 | Capacitor | C22 | CAP, 2.2µF, 35V, 10%, X5R, 0603 | Cap-0603 | GRM188R6YA225KA12D | Murata | - | C86017 | 2.2uF | 1 | 10 | LCSC (https://www.lcsc.com/product-detail/Multilayer-Ceramic-Capacitors-MLCC-SMD-SMT_Murata-Electronics-GRM188R6YA225KA12D_C86017.html) | $0.0692 | $0.6920
15 | Header | J1 | KK 254 Breakaway Header, Vertical, 2 Circuits, Tin (Sn) Plating, Mating Pin Length 6.09mm | HDR1X2_ | 22-28-4020 | Molex | - | C234182 | - | 1 | 5 | LCSC (https://www.lcsc.com/product-detail/Pin-Headers_MOLEX-22284020_C234182.html) | $0.0836 | $0.4180
16 | Header | J2 | 3A Straight Square Pins -40℃~+105℃ 3 2.54mm Black 1x3P Plugin,P=2.54mm Pin Headers ROHS | HDR1X3_ | C49257 | BOOMELE | - | C49257 | - | 1 | 50 | LCSC (https://www.lcsc.com/product-detail/Pin-Headers_BOOMELE-Boom-Precision-Elec-C49257_C49257.html) | $0.0141 | $0.7050
17 | Microphone | MK1 | 1.5V~3.6V Omnidirectional 120uA -42dB 400Ω 59dB SMD-4P,1.9x2.8mm MEMS Microphones ROHS | Custom | ZTS6117 | Zilltek | - | C481300 | - | 1 | 2 | LCSC (https://www.lcsc.com/product-detail/MEMS-Microphones_ZILLTEK-ZTS6117_C481300.html) | $0.1775 | $0.3550
18 | Potentiometer | R1, R10 | Trimmer, Cermet, Rest 100 Kilohms, PCB, 25 Turns, Pwr-Rtg 0.5W, 3296 Series | Custom | 3296W-1-104 | BOCHEN(Chengdu Guosheng Tech) | - | C330435 | 100k | 2 | 5 | LCSC (https://www.lcsc.com/product-detail/Variable-Resistors-Potentiometers_BOCHEN-Chengdu-Guosheng-Tech-3296W-1-104_C330435.html) | $0.3058 | $1.5290
19 | Resistor | R2, R3, R4, R7, R8, R9, R48, R52, R65, R66, R68, R69, R70 | RES SMD 10K OHM 0.1% 1/10W 0603 | Res-0603 | RT0603BRD0710KL | Yageo | - | C95204 | 10K | 13 | 20 | LCSC (https://www.lcsc.com/product-detail/Chip-Resistor-Surface-Mount_YAGEO-RT0603BRD0710KL_C95204.html) | $0.0223 | $0.4460
20 | Potentiometer | R5 | ±25% 500kΩ SMD Variable Resistors/Potentiometers ROHS | Custom | VG039NCHXTB504 | HDK | - | C128558 | 500k | 1 | 10 | LCSC (https://www.lcsc.com/product-detail/Variable-Resistors-Potentiometers_HDK-Hokuriku-Elec-Industry-VG039NCHXTB504_C128558.html) | $0.0755 | $0.7550
21 | Resistor | R6, R42, R43, R58 | RES SMD 1K OHM 0.1% 1/10W 0603 | Res-0603 | RT0603BRD071KL | Yageo | - | C110776 | 1K | 4 | 20 | LCSC (https://www.lcsc.com/product-detail/Chip-Resistor-Surface-Mount_YAGEO-RT0603BRD071KL_C110776.html) | $0.0225 | $0.4500
22 | Resistor | R11, R12 | RES SMD 3.3K OHM 0.1% 1/10W 0603 | Res-0603 | RT0603BRD073K3L | Yageo | - | C309653 | 3.3k | 2 | 20 | LCSC (https://www.lcsc.com/product-detail/Chip-Resistor-Surface-Mount_YAGEO-RT0603BRD073K3L_C309653.html) | $0.0300 | $0.6000
23 | Resistor | R13 | RES SMD 22K OHM 0.1% 1/10W 0603 | Res-0603 | RT0603BRD0722KL | Yageo | - | C469656 | 22K | 1 | 20 | LCSC (https://www.lcsc.com/product-detail/Chip-Resistor-Surface-Mount_YAGEO-RT0603BRD0722KL_C469656.html) | $0.0284 | $0.5680
24 | Potentiometer | R14 | Res Cermet Trimmer 500K Ohm 10% 1/2W 25(Elec)Turn | Custom | 3296W-1-504 | BOCHEN(Chengdu Guosheng Tech) | - | C330437 | 500k | 1 | 5 | LCSC (https://www.lcsc.com/product-detail/Variable-Resistors-Potentiometers_BOCHEN-Chengdu-Guosheng-Tech-3296W-1-504_C330437.html) | $0.3450 | $1.7250
25 | Resistor | R15, R16 | RES SMD 1.8K OHM 0.1% 1/10W 0603 | Res-0603 | RT0603BRD071K8L | Yageo | - | C705745 | 1.8K | 2 | 20 | LCSC (https://www.lcsc.com/product-detail/Chip-Resistor-Surface-Mount_YAGEO-RT0603BRD071K8L_C705745.html) | $0.0296 | $0.5920
26 | Resistor | R17 | RES SMD 270 OHM 0.1% 1/10W 0603 | Res-0603 | RT0603BRE07270RL | Yageo | - | C705836 | 270R | 1 | 20 | LCSC (https://www.lcsc.com/product-detail/Chip-Resistor-Surface-Mount_YAGEO-RT0603BRE07270RL_C705836.html) | $0.0272 | $0.5440
27 | Resistor | R18, R19 | ±1% 80kΩ 0603 Chip Resistor - Surface Mount ROHS | Res-0603 | ARG03FTC8002N | Viking Tech | - | C3014409 | 80K | 2 | 50 | LCSC (https://www.lcsc.com/product-detail/Chip-Resistor-Surface-Mount_Viking-Tech-ARG03FTC8002N_C3014409.html) | $0.0083 | $0.4150
28 | Resistor | R20, R21, R49 | ±0.1% 40kΩ 0805 Chip Resistor - Surface Mount ROHS | RES-0805 | AR05BTC4002 | Viking Tech | - | C5266069 | 40K | 3 | 10 | LCSC (https://www.lcsc.com/product-detail/Chip-Resistor-Surface-Mount_Viking-Tech-AR05BTC4002_C5266069.html) | $0.0430 | $0.4300
29 | Resistor | R22, R23 | ±25ppm/℃ ±0.1% 27kΩ 0402 Chip Resistor - Surface Mount ROHS | Res-0402 | ARG02BTC2702 | Viking Tech | - | C5266105 | 27K | 2 | 20 | LCSC (https://www.lcsc.com/product-detail/Chip-Resistor-Surface-Mount_Viking-Tech-ARG02BTC2702_C5266105.html) | $0.0251 | $0.5020
30 | Resistor | R24, R25, R50 | 100mW ±25ppm/℃ ±0.1% 20kΩ 0603 Chip Resistor - Surface Mount ROHS | Res-0603 | AR03BTCX2002 | Viking Tech | - | C319766 | 20K | 3 | 20 | LCSC (https://www.lcsc.com/product-detail/Chip-Resistor-Surface-Mount_Viking-Tech-AR03BTCX2002_C319766.html) | $0.0286 | $0.5720
31 | Resistor | R26, R27 | RES 16K OHM 0.5% 1/10W 0603 | Res-0603 | RC0603DR-0716KL | Yageo | - | C327136 | 16K | 2 | 50 | LCSC (https://www.lcsc.com/product-detail/Chip-Resistor-Surface-Mount_YAGEO-RC0603DR-0716KL_C327136.html) | $0.0082 | $0.4100
32 | Resistor | R28, R29, R53 | RES SMD 8.2K OHM 0.1% 1/10W 0603 | Res-0603 | RT0603BRD078K2L | Yageo | - | C861589 | 8.2K | 3 | 20 | LCSC (https://www.lcsc.com/product-detail/Chip-Resistor-Surface-Mount_YAGEO-RT0603BRD078K2L_C861589.html) | $0.0298 | $0.5960
33 | Resistor | R30, R31, R55 | RES 4.02K OHM 1% 1/16W 0402 | Res-0402 | RC0402FR-074K02L | Yageo | - | C137968 | 4.02K | 3 | 100 | LCSC (https://www.lcsc.com/product-detail/Chip-Resistor-Surface-Mount_YAGEO-RC0402FR-074K02L_C137968.html) | $0.0007 | $0.0700
34 | Resistor | R32, R33 | RES 2.7K OHM 1% 1/10W 0603 | Res-0603 | RC0603FR-072K7L | Yageo | - | C114612 | 2.7K | 2 | 100 | LCSC (https://www.lcsc.com/product-detail/Chip-Resistor-Surface-Mount_YAGEO-RC0603FR-072K7L_C114612.html) | $0.0012 | $0.1200
35 | Resistor | R34, R35, R56 | 100mW ±25ppm/℃ ±0.1% 2kΩ 0603 Chip Resistor - Surface Mount ROHS | Res-0603 | AR03BTCX2001 | Viking Tech | - | C318130 | 2K | 3 | 20 | LCSC (https://www.lcsc.com/product-detail/Chip-Resistor-Surface-Mount_Viking-Tech-AR03BTCX2001_C318130.html) | $0.0272 | $0.5440
36 | Resistor | R36, R37 | RES SMD 1.6K OHM 0.1% 1/16W 0402 | Res-0402 | RT0402BRD071K6L | Yageo | - | C852616 | 1.6K | 2 | 20 | LCSC (https://www.lcsc.com/product-detail/Chip-Resistor-Surface-Mount_YAGEO-RT0402BRD071K6L_C852616.html) | $0.0249 | $0.4980
37 | Resistor | R38, R39, R57 | 100mW ±25ppm/℃ ±0.1% 1.3kΩ 0603 Chip Resistor - Surface Mount ROHS | Res-0603 | AR03BTCX1301 | Viking Tech | - | C2984321 | 1.3K | 3 | 20 | LCSC (https://www.lcsc.com/product-detail/Chip-Resistor-Surface-Mount_Viking-Tech-AR03BTCX1301_C2984321.html) | $0.0302 | $0.6040
38 | Resistor | R40, R41 | RES SMD 1.1K OHM 0.1% 1/10W 0603 | Res-0603 | RT0603BRD071K1L | Yageo | - | C705736 | 1.1K | 2 | 20 | LCSC (https://www.lcsc.com/product-detail/Chip-Resistor-Surface-Mount_YAGEO-RT0603BRD071K1L_C705736.html) | $0.0278 | $0.5560
39 | Resistor | R44, R45 | 125mW Thin Film Resistor 150V ±25ppm/℃ ±0.1% -55℃~+155℃ 900Ω 0805 Chip Resistor - Surface Mount ROHS | RES-0805 | ARG05BTC9000N | Viking Tech | - | C2828704 | 900R | 2 | 20 | LCSC (https://www.lcsc.com/product-detail/Chip-Resistor-Surface-Mount_Viking-Tech-ARG05BTC9000N_C2828704.html) | $0.0324 | $0.6480
40 | Resistor | R46, R47, R59 | RES SMD 806 OHM 0.1% 1/16W 0402 | Res-0402 | RT0402BRD07806RL | Yageo | - | C852922 | 806R | 3 | 20 | LCSC (https://www.lcsc.com/product-detail/Chip-Resistor-Surface-Mount_YAGEO-RT0402BRD07806RL_C852922.html) | $0.0258 | $0.5160
41 | Resistor | R51 | RES SMD 13.3KOHM 0.1% 1/10W 0603 | Res-0603 | RT0603BRD0713K3L | Yageo | - | C861117 | 13.3K | 1 | 20 | LCSC (https://www.lcsc.com/product-detail/Chip-Resistor-Surface-Mount_YAGEO-RT0603BRD0713K3L_C861117.html) | $0.0294 | $0.5880
42 | Resistor | R54 | 125mW Thick Film Resistors 150V ±100ppm/℃ ±1% -55℃~+155℃ 98kΩ 0805 Chip Resistor - Surface Mount ROHS | RES-0805 | FRC0805F9802TS | FOJAN | - | C2933514 | 98K | 1 | 100 | LCSC (https://www.lcsc.com/product-detail/Chip-Resistor-Surface-Mount_FOJAN-FRC0805F9802TS_C2933514.html) | $0.0019 | $0.1900
43 | Resistor | R60 | RES SMD 649 OHM 0.1% 1/8W 0805 | RES-0805 | RT0805BRD07649RL | Yageo | - | C865602 | 649R | 1 | 20 | LCSC (https://www.lcsc.com/product-detail/Chip-Resistor-Surface-Mount_YAGEO-RT0805BRD07649RL_C865602.html) | $0.0386 | $0.7720
44 | Resistor | R61 | 62.5mW Thin Film Resistor 50V ±25ppm/℃ ±0.1% -55℃~+155℃ 549Ω 0402 Chip Resistor - Surface Mount ROHS | Res-0402 | ARG02BTC5490 | Viking Tech | - | C2684524 | 549R | 1 | 20 | LCSC (https://www.lcsc.com/product-detail/Chip-Resistor-Surface-Mount_Viking-Tech-ARG02BTC5490_C2684524.html) | $0.0217 | $0.4340
45 | Resistor | R62 | 125mW Thin Film Resistor 150V ±25ppm/℃ ±0.1% -55℃~+155℃ 500Ω 0805 Chip Resistor - Surface Mount ROHS | RES-0805 | ARG05BTC5000 | Viking Tech | - | C2828711 | 500R | 1 | 20 | LCSC (https://www.lcsc.com/product-detail/Chip-Resistor-Surface-Mount_Viking-Tech-ARG05BTC5000_C2828711.html) | $0.0312 | $0.6240
46 | Resistor | R63 | RES SMD 453 OHM 0.1% 1/16W 0402 | Res-0402 | RT0402BRD07453RL | Yageo | - | C852794 | 453R | 1 | 20 | LCSC (https://www.lcsc.com/product-detail/Chip-Resistor-Surface-Mount_YAGEO-RT0402BRD07453RL_C852794.html) | $0.0252 | $0.5040
47 | Resistor | R64 | 100mW Thin Film Resistor 75V ±25ppm/℃ ±0.1% -55℃~+155℃ 402Ω 0603 Chip Resistor - Surface Mount ROHS | Res-0603 | ARG03BTC4020 | Viking Tech | - | C2683044 | 402R | 1 | 20 | LCSC (https://www.lcsc.com/product-detail/Chip-Resistor-Surface-Mount_Viking-Tech-ARG03BTC4020_C2683044.html) | $0.0237 | $0.4740
48 | Potentiometer | R67 | TRIMMER 100K OHM 0.1W J LEAD TOP | Custom | TC33X-2-104E | Bourns |  | C719186 | 100k | 1 | 5 | LCSC (https://www.lcsc.com/product-detail/Variable-Resistors-Potentiometers_BOURNS-TC33X-2-104E_C719186.html) | $0.1440 | $0.7200
49 | Resistor | R71, R72 | RES SMD 47K OHM 0.1% 1/10W 0603 | Res-0603 | RT0603BRD0747KL | Yageo | - | C326725 | 47K | 2 | 20 | LCSC (https://www.lcsc.com/product-detail/Chip-Resistor-Surface-Mount_YAGEO-RT0603BRD0747KL_C326725.html) | $0.0254 | $0.5080
50 | Solder Bridge | ~~SB1, SB2~~ | ~~Solder Bridge ON~~ | ~~Custom~~ | ~~Solder Bridge~~ | ~~-~~ | - | ~~-~~ | ~~-~~ | ~~2~~ | ~~10~~ | ~~-~~ | ~~-~~ | -
51 | Switch | SW1, SW2, SW3, SW4, SW5, SW6, SW7, SW8, SW9 | Gull Wing SPST 24V 25mA Black -20℃~+70℃ 3000 Flat dial, raised type 2.54mm 5 SMD-10P,6x12.6mm DIP Switches ROHS | Custom | DSIC05LS-P | XKB Connectivity | - | C319036 | - | 9 | 20 | LCSC (https://www.lcsc.com/product-detail/DIP-Switches_XKB-Connectivity-DSIC05LS-P_C319036.html) | $0.5171 | $10.3420
52 | IC | U1, U2, U3 | General Purpose Amplifier 2 Circuit 8-SO | SOIC-8 | LM2904DT | STMicroelectronics | - | C105411 | - | 3 | 10 | LCSC (https://www.lcsc.com/product-detail/Operational-Amplifier_STMicroelectronics-LM2904DT_C105411.html) | $0.1139 | $1.1390
 |  |  |  |  |  |  |  |  |  |  | Total Component Cost |  |  | $39.12

Sheet: 2 Boards
 |  | Component list |  | Bill of Materials for Project [Xponent-tech]
 |  | Source Data From: |  | Xponent-tech
 |  | Project: |  | Xponent-tech
 |  | Variant: |  | None
# | Item Type | Designator | Description | Footprint | Manufacturer Part Number | Manufacturer | Alternate Part Number | LCSC Part Number | Value | Quantity | Quantity (2 Boards) | MOQ (2 Boards) | Links | Unit Cost (2 Boards) | Total Cost (2 Boards) | Remarks | Reviewer Remarks
1 | Capacitor | C1, C2, C10, C13 | CAP CER 0.1UF 50V X7R 0603 | CAP-0603 | CL10B104KB8NNNL | Samsung | - | C913912 | 0.1uF | 4 | 8 | 100 | LCSC (https://www.lcsc.com/product-detail/Multilayer-Ceramic-Capacitors-MLCC-SMD-SMT_Samsung-Electro-Mechanics-CL10B104KB8NNNL_C913912.html) | $0.0060 | $0.6000
2 | Capacitor | C3, C5, C17, C20 | CAP CER 1UF 50V X7R 0603 | Cap-0603 | UMK107AB7105KA-T | Taiyo Yuden | - | C105174 | 1uF | 4 | 8 | 20 | LCSC (https://www.lcsc.com/product-detail/Multilayer-Ceramic-Capacitors-MLCC-SMD-SMT_Taiyo-Yuden-UMK107AB7105KA-T_C105174.html) | $0.0289 | $0.5780
3 | Capacitor | C4 | CAP CER 47PF 100V NPO 0603 | Cap-0603 | AC0603JRNPO0BN470 | Yageo | - | C389107 | 47pF | 1 | 2 | 50 | LCSC (https://www.lcsc.com/product-detail/Multilayer-Ceramic-Capacitors-MLCC-SMD-SMT_YAGEO-AC0603JRNPO0BN470_C389107.html) | $0.0085 | $0.4250
4 | Capacitor | C6 | CAP CER 0.047UF 50V X8R 0603 | Cap-0603 | ~~CGA3E2X8R1H473M080AA~~ | TDK | FN18X473K500PBG | C525277 | 47nF | 1 | 2 | 100 | LCSC (https://www.lcsc.com/product-detail/Multilayer-Ceramic-Capacitors-MLCC-SMD-SMT_PSA-Prosperity-Dielectrics-FN18X473K500PBG_C525277.html) | $0.0030 | $0.3000
5 | Capacitor | C7 | CAP CER 4700PF 50V C0G/NPO 0603 | Cap-0603 | CC0603JRNPO9BN472 | Yageo | - | C576818 | 4.7nF | 1 | 2 | 20 | LCSC (https://www.lcsc.com/product-detail/Multilayer-Ceramic-Capacitors-MLCC-SMD-SMT_YAGEO-CC0603JRNPO9BN472_C576818.html) | $0.0217 | $0.4340
6 | Capacitor | C8, C18 | CAP ALUM 10uF 25V SMD | Custom | RVT1E100M0405 | ROQANG | - | C970655 | 10uF | 2 | 4 | 20 | LCSC (https://www.lcsc.com/product-detail/Aluminum-Electrolytic-Capacitors-SMD_DMBJ-RVT1E100M0405_C970655.html) | $0.0279 | $0.5580
7 | Capacitor | C9 | CAP CER 0.022UF 100V X7R 0603 | Cap-0603 | ~~CGA3E2X7R2A223K080AA~~ | TDK | CC0603KRX7R0BB223 | C313105 | 22nF | 1 | 2 | 50 | LCSC (https://www.lcsc.com/product-detail/Multilayer-Ceramic-Capacitors-MLCC-SMD-SMT_YAGEO-CC0603KRX7R0BB223_C313105.html) | $0.0090 | $0.4500
8 | Capacitor | C11 | 100V 4.2nF X7R ±10% 0402 Multilayer Ceramic Capacitors MLCC - SMD/SMT ROHS | Cap-0402 | GCM155R72A472KA01D | Murata Electronics | - | C2980803 | 4.2nF | 1 | 2 | 50 | LCSC (https://www.lcsc.com/product-detail/Multilayer-Ceramic-Capacitors-MLCC-SMD-SMT_Murata-Electronics-GCM155R72A472KA01D_C2980803.html) | $0.0092 | $0.4600
9 | Capacitor | C12 | CAP CER 1200PF 25V X7R 0402 | Cap-0402 | ~~C0402C122K3RAC7867~~ | KEMET | 0402B122K250CT | C458850 | 1.2nF | 1 | 2 | 100 | LCSC (https://www.lcsc.com/product-detail/Multilayer-Ceramic-Capacitors-MLCC-SMD-SMT_Walsin-Tech-Corp-0402B122K250CT_C458850.html) | $0.0038 | $0.3800
10 | Capacitor | C14, C15 | 50V 100nF C0G ±1% 1206 Multilayer Ceramic Capacitors MLCC - SMD/SMT ROHS | Cap-1206 | GRM31C5C1H104FA01L | Murata Electronics | - | C2981728 | 0.1uF | 2 | 4 | 5 | LCSC (https://www.lcsc.com/product-detail/Multilayer-Ceramic-Capacitors-MLCC-SMD-SMT_Murata-Electronics-GRM31C5C1H104FA01L_C2981728.html) | $0.4137 | $2.0685
11 | Capacitor | C16 | 50V 200nF ±10% 0805 Multilayer Ceramic Capacitors MLCC - SMD/SMT ROHS | Cap-0805 | NL0805B204K500CPBN | HUI JU | - | C918135 | 0.2uF | 1 | 2 | 50 | LCSC (https://www.lcsc.com/product-detail/Multilayer-Ceramic-Capacitors-MLCC-SMD-SMT_HUI-JU-NL0805B204K500CPBN_C918135.html) | $0.0129 | $0.6450
12 | Capacitor | C19 | CAP CER 4.7UF 50V X7R 1206 | Cap-1206 | ~~C3216X7R1H475K160AC~~ | TDK | GRM31CR61E476ME44L | C403725 | 4.7uF | 1 | 2 | 3 | LCSC (https://www.lcsc.com/product-detail/Multilayer-Ceramic-Capacitors-MLCC-SMD-SMT_Murata-Electronics-GRM31CR61E476ME44L_C403725.html) | $0.3182 | $0.9546
13 | Capacitor | C21 | CAP CER 33PF 25V C0G/NP0 0402 | Cap-0402 | ~~GRM1555C1E330JA01D~~ | Murata | 0402N330K250CT | C387979 | 33pF | 1 | 2 | 50 | LCSC (https://www.lcsc.com/product-detail/Multilayer-Ceramic-Capacitors-MLCC-SMD-SMT_Walsin-Tech-Corp-0402N330K250CT_C387979.html) | $0.0051 | $0.2550
14 | Capacitor | C22 | CAP, 2.2µF, 35V, 10%, X5R, 0603 | Cap-0603 | GRM188R6YA225KA12D | Murata | - | C86017 | 2.2uF | 1 | 2 | 10 | LCSC (https://www.lcsc.com/product-detail/Multilayer-Ceramic-Capacitors-MLCC-SMD-SMT_Murata-Electronics-GRM188R6YA225KA12D_C86017.html) | $0.0692 | $0.6920
15 | Header | J1 | KK 254 Breakaway Header, Vertical, 2 Circuits, Tin (Sn) Plating, Mating Pin Length 6.09mm | HDR1X2_ | 22-28-4020 | Molex | - | C234182 | - | 1 | 2 | 5 | LCSC (https://www.lcsc.com/product-detail/Pin-Headers_MOLEX-22284020_C234182.html) | $0.0836 | $0.4180
16 | Header | J2 | 3A Straight Square Pins -40℃~+105℃ 3 2.54mm Black 1x3P Plugin,P=2.54mm Pin Headers ROHS | HDR1X3_ | C49257 | BOOMELE | - | C49257 | - | 1 | 2 | 50 | LCSC (https://www.lcsc.com/product-detail/Pin-Headers_BOOMELE-Boom-Precision-Elec-C49257_C49257.html) | $0.0141 | $0.7050
17 | Microphone | MK1 | 1.5V~3.6V Omnidirectional 120uA -42dB 400Ω 59dB SMD-4P,1.9x2.8mm MEMS Microphones ROHS | Custom | ZTS6117 | Zilltek | - | C481300 | - | 1 | 2 | 3 | LCSC (https://www.lcsc.com/product-detail/MEMS-Microphones_ZILLTEK-ZTS6117_C481300.html) | $0.1775 | $0.5325
18 | Potentiometer | R1, R10 | Trimmer, Cermet, Rest 100 Kilohms, PCB, 25 Turns, Pwr-Rtg 0.5W, 3296 Series | Custom | 3296W-1-104 | BOCHEN(Chengdu Guosheng Tech) | - | C330435 | 100k | 2 | 4 | 5 | LCSC (https://www.lcsc.com/product-detail/Variable-Resistors-Potentiometers_BOCHEN-Chengdu-Guosheng-Tech-3296W-1-104_C330435.html) | $0.3058 | $1.5290
19 | Resistor | R2, R3, R4, R7, R8, R9, R48, R52, R65, R66, R68, R69, R70 | RES SMD 10K OHM 0.1% 1/10W 0603 | Res-0603 | RT0603BRD0710KL | Yageo | - | C95204 | 10K | 13 | 26 | 40 | LCSC (https://www.lcsc.com/product-detail/Chip-Resistor-Surface-Mount_YAGEO-RT0603BRD0710KL_C95204.html) | $0.0223 | $0.8920
20 | Potentiometer | R5 | ±25% 500kΩ SMD Variable Resistors/Potentiometers ROHS | Custom | VG039NCHXTB504 | HDK | - | C128558 | 500k | 1 | 2 | 10 | LCSC (https://www.lcsc.com/product-detail/Variable-Resistors-Potentiometers_HDK-Hokuriku-Elec-Industry-VG039NCHXTB504_C128558.html) | $0.0755 | $0.7550
21 | Resistor | R6, R42, R43, R58 | RES SMD 1K OHM 0.1% 1/10W 0603 | Res-0603 | RT0603BRD071KL | Yageo | - | C110776 | 1K | 4 | 8 | 20 | LCSC (https://www.lcsc.com/product-detail/Chip-Resistor-Surface-Mount_YAGEO-RT0603BRD071KL_C110776.html) | $0.0225 | $0.4500
22 | Resistor | R11, R12 | RES SMD 3.3K OHM 0.1% 1/10W 0603 | Res-0603 | RT0603BRD073K3L | Yageo | - | C309653 | 3.3k | 2 | 4 | 20 | LCSC (https://www.lcsc.com/product-detail/Chip-Resistor-Surface-Mount_YAGEO-RT0603BRD073K3L_C309653.html) | $0.0300 | $0.6000
23 | Resistor | R13 | RES SMD 22K OHM 0.1% 1/10W 0603 | Res-0603 | RT0603BRD0722KL | Yageo | - | C469656 | 22K | 1 | 2 | 20 | LCSC (https://www.lcsc.com/product-detail/Chip-Resistor-Surface-Mount_YAGEO-RT0603BRD0722KL_C469656.html) | $0.0284 | $0.5680
24 | Potentiometer | R14 | Res Cermet Trimmer 500K Ohm 10% 1/2W 25(Elec)Turn | Custom | 3296W-1-504 | BOCHEN(Chengdu Guosheng Tech) | - | C330437 | 500k | 1 | 2 | 5 | LCSC (https://www.lcsc.com/product-detail/Variable-Resistors-Potentiometers_BOCHEN-Chengdu-Guosheng-Tech-3296W-1-504_C330437.html) | $0.3450 | $1.7250
25 | Resistor | R15, R16 | RES SMD 1.8K OHM 0.1% 1/10W 0603 | Res-0603 | RT0603BRD071K8L | Yageo | - | C705745 | 1.8K | 2 | 4 | 20 | LCSC (https://www.lcsc.com/product-detail/Chip-Resistor-Surface-Mount_YAGEO-RT0603BRD071K8L_C705745.html) | $0.0296 | $0.5920
26 | Resistor | R17 | RES SMD 270 OHM 0.1% 1/10W 0603 | Res-0603 | RT0603BRE07270RL | Yageo | - | C705836 | 270R | 1 | 2 | 20 | LCSC (https://www.lcsc.com/product-detail/Chip-Resistor-Surface-Mount_YAGEO-RT0603BRE07270RL_C705836.html) | $0.0272 | $0.5440
27 | Resistor | R18, R19 | ±1% 80kΩ 0603 Chip Resistor - Surface Mount ROHS | Res-0603 | ARG03FTC8002N | Viking Tech | - | C3014409 | 80K | 2 | 4 | 50 | LCSC (https://www.lcsc.com/product-detail/Chip-Resistor-Surface-Mount_Viking-Tech-ARG03FTC8002N_C3014409.html) | $0.0083 | $0.4150
28 | Resistor | R20, R21, R49 | ±0.1% 40kΩ 0805 Chip Resistor - Surface Mount ROHS | RES-0805 | AR05BTC4002 | Viking Tech | - | C5266069 | 40K | 3 | 6 | 10 | LCSC (https://www.lcsc.com/product-detail/Chip-Resistor-Surface-Mount_Viking-Tech-AR05BTC4002_C5266069.html) | $0.0430 | $0.4300
29 | Resistor | R22, R23 | ±25ppm/℃ ±0.1% 27kΩ 0402 Chip Resistor - Surface Mount ROHS | Res-0402 | ARG02BTC2702 | Viking Tech | - | C5266105 | 27K | 2 | 4 | 20 | LCSC (https://www.lcsc.com/product-detail/Chip-Resistor-Surface-Mount_Viking-Tech-ARG02BTC2702_C5266105.html) | $0.0251 | $0.5020
30 | Resistor | R24, R25, R50 | 100mW ±25ppm/℃ ±0.1% 20kΩ 0603 Chip Resistor - Surface Mount ROHS | Res-0603 | AR03BTCX2002 | Viking Tech | - | C319766 | 20K | 3 | 6 | 20 | LCSC (https://www.lcsc.com/product-detail/Chip-Resistor-Surface-Mount_Viking-Tech-AR03BTCX2002_C319766.html) | $0.0286 | $0.5720
31 | Resistor | R26, R27 | RES 16K OHM 0.5% 1/10W 0603 | Res-0603 | RC0603DR-0716KL | Yageo | - | C327136 | 16K | 2 | 4 | 50 | LCSC (https://www.lcsc.com/product-detail/Chip-Resistor-Surface-Mount_YAGEO-RC0603DR-0716KL_C327136.html) | $0.0082 | $0.4100
32 | Resistor | R28, R29, R53 | RES SMD 8.2K OHM 0.1% 1/10W 0603 | Res-0603 | RT0603BRD078K2L | Yageo | - | C861589 | 8.2K | 3 | 6 | 20 | LCSC (https://www.lcsc.com/product-detail/Chip-Resistor-Surface-Mount_YAGEO-RT0603BRD078K2L_C861589.html) | $0.0298 | $0.5960
33 | Resistor | R30, R31, R55 | RES 4.02K OHM 1% 1/16W 0402 | Res-0402 | RC0402FR-074K02L | Yageo | - | C137968 | 4.02K | 3 | 6 | 100 | LCSC (https://www.lcsc.com/product-detail/Chip-Resistor-Surface-Mount_YAGEO-RC0402FR-074K02L_C137968.html) | $0.0007 | $0.0700
34 | Resistor | R32, R33 | RES 2.7K OHM 1% 1/10W 0603 | Res-0603 | RC0603FR-072K7L | Yageo | - | C114612 | 2.7K | 2 | 4 | 100 | LCSC (https://www.lcsc.com/product-detail/Chip-Resistor-Surface-Mount_YAGEO-RC0603FR-072K7L_C114612.html) | $0.0012 | $0.1200
35 | Resistor | R34, R35, R56 | 100mW ±25ppm/℃ ±0.1% 2kΩ 0603 Chip Resistor - Surface Mount ROHS | Res-0603 | AR03BTCX2001 | Viking Tech | - | C318130 | 2K | 3 | 6 | 20 | LCSC (https://www.lcsc.com/product-detail/Chip-Resistor-Surface-Mount_Viking-Tech-AR03BTCX2001_C318130.html) | $0.0272 | $0.5440
36 | Resistor | R36, R37 | RES SMD 1.6K OHM 0.1% 1/16W 0402 | Res-0402 | RT0402BRD071K6L | Yageo | - | C852616 | 1.6K | 2 | 4 | 20 | LCSC (https://www.lcsc.com/product-detail/Chip-Resistor-Surface-Mount_YAGEO-RT0402BRD071K6L_C852616.html) | $0.0249 | $0.4980
37 | Resistor | R38, R39, R57 | 100mW ±25ppm/℃ ±0.1% 1.3kΩ 0603 Chip Resistor - Surface Mount ROHS | Res-0603 | AR03BTCX1301 | Viking Tech | - | C2984321 | 1.3K | 3 | 6 | 20 | LCSC (https://www.lcsc.com/product-detail/Chip-Resistor-Surface-Mount_Viking-Tech-AR03BTCX1301_C2984321.html) | $0.0302 | $0.6040
38 | Resistor | R40, R41 | RES SMD 1.1K OHM 0.1% 1/10W 0603 | Res-0603 | RT0603BRD071K1L | Yageo | - | C705736 | 1.1K | 2 | 4 | 20 | LCSC (https://www.lcsc.com/product-detail/Chip-Resistor-Surface-Mount_YAGEO-RT0603BRD071K1L_C705736.html) | $0.0278 | $0.5560
39 | Resistor | R44, R45 | 125mW Thin Film Resistor 150V ±25ppm/℃ ±0.1% -55℃~+155℃ 900Ω 0805 Chip Resistor - Surface Mount ROHS | RES-0805 | ARG05BTC9000N | Viking Tech | - | C2828704 | 900R | 2 | 4 | 20 | LCSC (https://www.lcsc.com/product-detail/Chip-Resistor-Surface-Mount_Viking-Tech-ARG05BTC9000N_C2828704.html) | $0.0324 | $0.6480
40 | Resistor | R46, R47, R59 | RES SMD 806 OHM 0.1% 1/16W 0402 | Res-0402 | RT0402BRD07806RL | Yageo | - | C852922 | 806R | 3 | 6 | 20 | LCSC (https://www.lcsc.com/product-detail/Chip-Resistor-Surface-Mount_YAGEO-RT0402BRD07806RL_C852922.html) | $0.0258 | $0.5160
41 | Resistor | R51 | RES SMD 13.3KOHM 0.1% 1/10W 0603 | Res-0603 | RT0603BRD0713K3L | Yageo | - | C861117 | 13.3K | 1 | 2 | 20 | LCSC (https://www.lcsc.com/product-detail/Chip-Resistor-Surface-Mount_YAGEO-RT0603BRD0713K3L_C861117.html) | $0.0294 | $0.5880
42 | Resistor | R54 | 125mW Thick Film Resistors 150V ±100ppm/℃ ±1% -55℃~+155℃ 98kΩ 0805 Chip Resistor - Surface Mount ROHS | RES-0805 | FRC0805F9802TS | FOJAN | - | C2933514 | 98K | 1 | 2 | 100 | LCSC (https://www.lcsc.com/product-detail/Chip-Resistor-Surface-Mount_FOJAN-FRC0805F9802TS_C2933514.html) | $0.0019 | $0.1900
43 | Resistor | R60 | RES SMD 649 OHM 0.1% 1/8W 0805 | RES-0805 | RT0805BRD07649RL | Yageo | - | C865602 | 649R | 1 | 2 | 20 | LCSC (https://www.lcsc.com/product-detail/Chip-Resistor-Surface-Mount_YAGEO-RT0805BRD07649RL_C865602.html) | $0.0386 | $0.7720
44 | Resistor | R61 | 62.5mW Thin Film Resistor 50V ±25ppm/℃ ±0.1% -55℃~+155℃ 549Ω 0402 Chip Resistor - Surface Mount ROHS | Res-0402 | ARG02BTC5490 | Viking Tech | - | C2684524 | 549R | 1 | 2 | 20 | LCSC (https://www.lcsc.com/product-detail/Chip-Resistor-Surface-Mount_Viking-Tech-ARG02BTC5490_C2684524.html) | $0.0217 | $0.4340
45 | Resistor | R62 | 125mW Thin Film Resistor 150V ±25ppm/℃ ±0.1% -55℃~+155℃ 500Ω 0805 Chip Resistor - Surface Mount ROHS | RES-0805 | ARG05BTC5000 | Viking Tech | - | C2828711 | 500R | 1 | 2 | 20 | LCSC (https://www.lcsc.com/product-detail/Chip-Resistor-Surface-Mount_Viking-Tech-ARG05BTC5000_C2828711.html) | $0.0312 | $0.6240
46 | Resistor | R63 | RES SMD 453 OHM 0.1% 1/16W 0402 | Res-0402 | RT0402BRD07453RL | Yageo | - | C852794 | 453R | 1 | 2 | 20 | LCSC (https://www.lcsc.com/product-detail/Chip-Resistor-Surface-Mount_YAGEO-RT0402BRD07453RL_C852794.html) | $0.0252 | $0.5040
47 | Resistor | R64 | 100mW Thin Film Resistor 75V ±25ppm/℃ ±0.1% -55℃~+155℃ 402Ω 0603 Chip Resistor - Surface Mount ROHS | Res-0603 | ARG03BTC4020 | Viking Tech | - | C2683044 | 402R | 1 | 2 | 20 | LCSC (https://www.lcsc.com/product-detail/Chip-Resistor-Surface-Mount_Viking-Tech-ARG03BTC4020_C2683044.html) | $0.0237 | $0.4740
48 | Potentiometer | R67 | TRIMMER 100K OHM 0.1W J LEAD TOP | Custom | TC33X-2-104E | Bourns |  | C719186 | 100k | 1 | 2 | 5 | LCSC (https://www.lcsc.com/product-detail/Variable-Resistors-Potentiometers_BOURNS-TC33X-2-104E_C719186.html) | $0.1440 | $0.7200
49 | Resistor | R71, R72 | RES SMD 47K OHM 0.1% 1/10W 0603 | Res-0603 | RT0603BRD0747KL | Yageo | - | C326725 | 47K | 2 | 4 | 20 | LCSC (https://www.lcsc.com/product-detail/Chip-Resistor-Surface-Mount_YAGEO-RT0603BRD0747KL_C326725.html) | $0.0254 | $0.5080
50 | Solder Bridge | ~~SB1, SB2~~ | ~~Solder Bridge ON~~ | ~~Custom~~ | ~~Solder Bridge~~ | ~~-~~ | - | ~~-~~ | ~~-~~ | ~~2~~ | 4 | 10 | ~~-~~ | ~~-~~ | -
51 | Switch | SW1, SW2, SW3, SW4, SW5, SW6, SW7, SW8, SW9 | Gull Wing SPST 24V 25mA Black -20℃~+70℃ 3000 Flat dial, raised type 2.54mm 5 SMD-10P,6x12.6mm DIP Switches ROHS | Custom | DSIC05LS-P | XKB Connectivity | - | C319036 | - | 9 | 18 | 20 | LCSC (https://www.lcsc.com/product-detail/DIP-Switches_XKB-Connectivity-DSIC05LS-P_C319036.html) | $0.5171 | $10.3420
52 | IC | U1, U2, U3 | General Purpose Amplifier 2 Circuit 8-SO | SOIC-8 | LM2904DT | STMicroelectronics | - | C105411 | - | 3 | 6 | 10 | LCSC (https://www.lcsc.com/product-detail/Operational-Amplifier_STMicroelectronics-LM2904DT_C105411.html) | $0.1139 | $1.1390
 |  |  |  |  |  |  |  |  |  |  |  | Total Component Cost |  |  | $40.89
 |  |  |  |  |  |  |  |  |  |  |  | Single Board Cost |  |  | $20.44

Sheet: 5 Boards
 |  | Component list |  | Bill of Materials for Project [Xponent-tech]
 |  | Source Data From: |  | Xponent-tech
 |  | Project: |  | Xponent-tech
 |  | Variant: |  | None
# | Item Type | Designator | Description | Footprint | Manufacturer Part Number | Manufacturer | Alternate Part Number | LCSC Part Number | Value | Quantity | Quantity (5 Boards) | MOQ (5 Boards) | Links | Unit Cost (5 Boards) | Total Cost (5 Boards) | Remarks | Reviewer Remarks
1 | Capacitor | C1, C2, C10, C13 | CAP CER 0.1UF 50V X7R 0603 | CAP-0603 | CL10B104KB8NNNL | Samsung | - | C913912 | 0.1uF | 4 | 20 | 100 | LCSC (https://www.lcsc.com/product-detail/Multilayer-Ceramic-Capacitors-MLCC-SMD-SMT_Samsung-Electro-Mechanics-CL10B104KB8NNNL_C913912.html) | $0.0060 | $0.6000
2 | Capacitor | C3, C5, C17, C20 | CAP CER 1UF 50V X7R 0603 | Cap-0603 | UMK107AB7105KA-T | Taiyo Yuden | - | C105174 | 1uF | 4 | 20 | 40 | LCSC (https://www.lcsc.com/product-detail/Multilayer-Ceramic-Capacitors-MLCC-SMD-SMT_Taiyo-Yuden-UMK107AB7105KA-T_C105174.html) | $0.0289 | $1.1560
3 | Capacitor | C4 | CAP CER 47PF 100V NPO 0603 | Cap-0603 | AC0603JRNPO0BN470 | Yageo | - | C389107 | 47pF | 1 | 5 | 50 | LCSC (https://www.lcsc.com/product-detail/Multilayer-Ceramic-Capacitors-MLCC-SMD-SMT_YAGEO-AC0603JRNPO0BN470_C389107.html) | $0.0085 | $0.4250
4 | Capacitor | C6 | CAP CER 0.047UF 50V X8R 0603 | Cap-0603 | ~~CGA3E2X8R1H473M080AA~~ | TDK | FN18X473K500PBG | C525277 | 47nF | 1 | 5 | 100 | LCSC (https://www.lcsc.com/product-detail/Multilayer-Ceramic-Capacitors-MLCC-SMD-SMT_PSA-Prosperity-Dielectrics-FN18X473K500PBG_C525277.html) | $0.0030 | $0.3000
5 | Capacitor | C7 | CAP CER 4700PF 50V C0G/NPO 0603 | Cap-0603 | CC0603JRNPO9BN472 | Yageo | - | C576818 | 4.7nF | 1 | 5 | 20 | LCSC (https://www.lcsc.com/product-detail/Multilayer-Ceramic-Capacitors-MLCC-SMD-SMT_YAGEO-CC0603JRNPO9BN472_C576818.html) | $0.0217 | $0.4340
6 | Capacitor | C8, C18 | CAP ALUM 10uF 25V SMD | Custom | RVT1E100M0405 | ROQANG | - | C970655 | 10uF | 2 | 10 | 20 | LCSC (https://www.lcsc.com/product-detail/Aluminum-Electrolytic-Capacitors-SMD_DMBJ-RVT1E100M0405_C970655.html) | $0.0279 | $0.5580
7 | Capacitor | C9 | CAP CER 0.022UF 100V X7R 0603 | Cap-0603 | ~~CGA3E2X7R2A223K080AA~~ | TDK | CC0603KRX7R0BB223 | C313105 | 22nF | 1 | 5 | 50 | LCSC (https://www.lcsc.com/product-detail/Multilayer-Ceramic-Capacitors-MLCC-SMD-SMT_YAGEO-CC0603KRX7R0BB223_C313105.html) | $0.0090 | $0.4500
8 | Capacitor | C11 | 100V 4.2nF X7R ±10% 0402 Multilayer Ceramic Capacitors MLCC - SMD/SMT ROHS | Cap-0402 | GCM155R72A472KA01D | Murata Electronics | - | C2980803 | 4.2nF | 1 | 5 | 50 | LCSC (https://www.lcsc.com/product-detail/Multilayer-Ceramic-Capacitors-MLCC-SMD-SMT_Murata-Electronics-GCM155R72A472KA01D_C2980803.html) | $0.0092 | $0.4600
9 | Capacitor | C12 | CAP CER 1200PF 25V X7R 0402 | Cap-0402 | ~~C0402C122K3RAC7867~~ | KEMET | 0402B122K250CT | C458850 | 1.2nF | 1 | 5 | 100 | LCSC (https://www.lcsc.com/product-detail/Multilayer-Ceramic-Capacitors-MLCC-SMD-SMT_Walsin-Tech-Corp-0402B122K250CT_C458850.html) | $0.0038 | $0.3800
10 | Capacitor | C14, C15 | 50V 100nF C0G ±1% 1206 Multilayer Ceramic Capacitors MLCC - SMD/SMT ROHS | Cap-1206 | GRM31C5C1H104FA01L | Murata Electronics | - | C2981728 | 0.1uF | 2 | 10 | 11 | LCSC (https://www.lcsc.com/product-detail/Multilayer-Ceramic-Capacitors-MLCC-SMD-SMT_Murata-Electronics-GRM31C5C1H104FA01L_C2981728.html) | $0.4137 | $4.5507
11 | Capacitor | C16 | 50V 200nF ±10% 0805 Multilayer Ceramic Capacitors MLCC - SMD/SMT ROHS | Cap-0805 | NL0805B204K500CPBN | HUI JU | - | C918135 | 0.2uF | 1 | 5 | 50 | LCSC (https://www.lcsc.com/product-detail/Multilayer-Ceramic-Capacitors-MLCC-SMD-SMT_HUI-JU-NL0805B204K500CPBN_C918135.html) | $0.0129 | $0.6450
12 | Capacitor | C19 | CAP CER 4.7UF 50V X7R 1206 | Cap-1206 | ~~C3216X7R1H475K160AC~~ | TDK | GRM31CR61E476ME44L | C403725 | 4.7uF | 1 | 5 | 6 | LCSC (https://www.lcsc.com/product-detail/Multilayer-Ceramic-Capacitors-MLCC-SMD-SMT_Murata-Electronics-GRM31CR61E476ME44L_C403725.html) | $0.3182 | $1.9092
13 | Capacitor | C21 | CAP CER 33PF 25V C0G/NP0 0402 | Cap-0402 | ~~GRM1555C1E330JA01D~~ | Murata | 0402N330K250CT | C387979 | 33pF | 1 | 5 | 50 | LCSC (https://www.lcsc.com/product-detail/Multilayer-Ceramic-Capacitors-MLCC-SMD-SMT_Walsin-Tech-Corp-0402N330K250CT_C387979.html) | $0.0051 | $0.2550
14 | Capacitor | C22 | CAP, 2.2µF, 35V, 10%, X5R, 0603 | Cap-0603 | GRM188R6YA225KA12D | Murata | - | C86017 | 2.2uF | 1 | 5 | 10 | LCSC (https://www.lcsc.com/product-detail/Multilayer-Ceramic-Capacitors-MLCC-SMD-SMT_Murata-Electronics-GRM188R6YA225KA12D_C86017.html) | $0.0692 | $0.6920
15 | Header | J1 | KK 254 Breakaway Header, Vertical, 2 Circuits, Tin (Sn) Plating, Mating Pin Length 6.09mm | HDR1X2_ | 22-28-4020 | Molex | - | C234182 | - | 1 | 5 | 10 | LCSC (https://www.lcsc.com/product-detail/Pin-Headers_MOLEX-22284020_C234182.html) | $0.0836 | $0.8360
16 | Header | J2 | 3A Straight Square Pins -40℃~+105℃ 3 2.54mm Black 1x3P Plugin,P=2.54mm Pin Headers ROHS | HDR1X3_ | C49257 | BOOMELE | - | C49257 | - | 1 | 5 | 50 | LCSC (https://www.lcsc.com/product-detail/Pin-Headers_BOOMELE-Boom-Precision-Elec-C49257_C49257.html) | $0.0141 | $0.7050
17 | Microphone | MK1 | 1.5V~3.6V Omnidirectional 120uA -42dB 400Ω 59dB SMD-4P,1.9x2.8mm MEMS Microphones ROHS | Custom | ZTS6117 | Zilltek | - | C481300 | - | 1 | 5 | 6 | LCSC (https://www.lcsc.com/product-detail/MEMS-Microphones_ZILLTEK-ZTS6117_C481300.html) | $0.1775 | $1.0650
18 | Potentiometer | R1, R10 | Trimmer, Cermet, Rest 100 Kilohms, PCB, 25 Turns, Pwr-Rtg 0.5W, 3296 Series | Custom | 3296W-1-104 | BOCHEN(Chengdu Guosheng Tech) | - | C330435 | 100k | 2 | 10 | 15 | LCSC (https://www.lcsc.com/product-detail/Variable-Resistors-Potentiometers_BOCHEN-Chengdu-Guosheng-Tech-3296W-1-104_C330435.html) | $0.3058 | $4.5870
19 | Resistor | R2, R3, R4, R7, R8, R9, R48, R52, R65, R66, R68, R69, R70 | RES SMD 10K OHM 0.1% 1/10W 0603 | Res-0603 | RT0603BRD0710KL | Yageo | - | C95204 | 10K | 13 | 65 | 80 | LCSC (https://www.lcsc.com/product-detail/Chip-Resistor-Surface-Mount_YAGEO-RT0603BRD0710KL_C95204.html) | $0.0223 | $1.7840
20 | Potentiometer | R5 | ±25% 500kΩ SMD Variable Resistors/Potentiometers ROHS | Custom | VG039NCHXTB504 | HDK | - | C128558 | 500k | 1 | 5 | 10 | LCSC (https://www.lcsc.com/product-detail/Variable-Resistors-Potentiometers_HDK-Hokuriku-Elec-Industry-VG039NCHXTB504_C128558.html) | $0.0755 | $0.7550
21 | Resistor | R6, R42, R43, R58 | RES SMD 1K OHM 0.1% 1/10W 0603 | Res-0603 | RT0603BRD071KL | Yageo | - | C110776 | 1K | 4 | 20 | 40 | LCSC (https://www.lcsc.com/product-detail/Chip-Resistor-Surface-Mount_YAGEO-RT0603BRD071KL_C110776.html) | $0.0225 | $0.9000
22 | Resistor | R11, R12 | RES SMD 3.3K OHM 0.1% 1/10W 0603 | Res-0603 | RT0603BRD073K3L | Yageo | - | C309653 | 3.3k | 2 | 10 | 20 | LCSC (https://www.lcsc.com/product-detail/Chip-Resistor-Surface-Mount_YAGEO-RT0603BRD073K3L_C309653.html) | $0.0300 | $0.6000
23 | Resistor | R13 | RES SMD 22K OHM 0.1% 1/10W 0603 | Res-0603 | RT0603BRD0722KL | Yageo | - | C469656 | 22K | 1 | 5 | 20 | LCSC (https://www.lcsc.com/product-detail/Chip-Resistor-Surface-Mount_YAGEO-RT0603BRD0722KL_C469656.html) | $0.0284 | $0.5680
 | Potentiometer | R14 | Res Cermet Trimmer 500K Ohm 10% 1/2W 25(Elec)Turn | Custom | 3296W-1-504 | BOCHEN(Chengdu Guosheng Tech) | - | C330437 | 500k | 1 | 5 | 10 | LCSC (https://www.lcsc.com/product-detail/Variable-Resistors-Potentiometers_BOCHEN-Chengdu-Guosheng-Tech-3296W-1-504_C330437.html) | $0.3450 | $3.4500
25 | Resistor | R15, R16 | RES SMD 1.8K OHM 0.1% 1/10W 0603 | Res-0603 | RT0603BRD071K8L | Yageo | - | C705745 | 1.8K | 2 | 10 | 20 | LCSC (https://www.lcsc.com/product-detail/Chip-Resistor-Surface-Mount_YAGEO-RT0603BRD071K8L_C705745.html) | $0.0296 | $0.5920
26 | Resistor | R17 | RES SMD 270 OHM 0.1% 1/10W 0603 | Res-0603 | RT0603BRE07270RL | Yageo | - | C705836 | 270R | 1 | 5 | 20 | LCSC (https://www.lcsc.com/product-detail/Chip-Resistor-Surface-Mount_YAGEO-RT0603BRE07270RL_C705836.html) | $0.0272 | $0.5440
27 | Resistor | R18, R19 | ±1% 80kΩ 0603 Chip Resistor - Surface Mount ROHS | Res-0603 | ARG03FTC8002N | Viking Tech | - | C3014409 | 80K | 2 | 10 | 50 | LCSC (https://www.lcsc.com/product-detail/Chip-Resistor-Surface-Mount_Viking-Tech-ARG03FTC8002N_C3014409.html) | $0.0083 | $0.4150
28 | Resistor | R20, R21, R49 | ±0.1% 40kΩ 0805 Chip Resistor - Surface Mount ROHS | RES-0805 | AR05BTC4002 | Viking Tech | - | C5266069 | 40K | 3 | 15 | 20 | LCSC (https://www.lcsc.com/product-detail/Chip-Resistor-Surface-Mount_Viking-Tech-AR05BTC4002_C5266069.html) | $0.0430 | $0.8600
29 | Resistor | R22, R23 | ±25ppm/℃ ±0.1% 27kΩ 0402 Chip Resistor - Surface Mount ROHS | Res-0402 | ARG02BTC2702 | Viking Tech | - | C5266105 | 27K | 2 | 10 | 20 | LCSC (https://www.lcsc.com/product-detail/Chip-Resistor-Surface-Mount_Viking-Tech-ARG02BTC2702_C5266105.html) | $0.0251 | $0.5020
30 | Resistor | R24, R25, R50 | 100mW ±25ppm/℃ ±0.1% 20kΩ 0603 Chip Resistor - Surface Mount ROHS | Res-0603 | AR03BTCX2002 | Viking Tech | - | C319766 | 20K | 3 | 15 | 20 | LCSC (https://www.lcsc.com/product-detail/Chip-Resistor-Surface-Mount_Viking-Tech-AR03BTCX2002_C319766.html) | $0.0286 | $0.5720
31 | Resistor | R26, R27 | RES 16K OHM 0.5% 1/10W 0603 | Res-0603 | RC0603DR-0716KL | Yageo | - | C327136 | 16K | 2 | 10 | 50 | LCSC (https://www.lcsc.com/product-detail/Chip-Resistor-Surface-Mount_YAGEO-RC0603DR-0716KL_C327136.html) | $0.0082 | $0.4100
32 | Resistor | R28, R29, R53 | RES SMD 8.2K OHM 0.1% 1/10W 0603 | Res-0603 | RT0603BRD078K2L | Yageo | - | C861589 | 8.2K | 3 | 15 | 20 | LCSC (https://www.lcsc.com/product-detail/Chip-Resistor-Surface-Mount_YAGEO-RT0603BRD078K2L_C861589.html) | $0.0298 | $0.5960
33 | Resistor | R30, R31, R55 | RES 4.02K OHM 1% 1/16W 0402 | Res-0402 | RC0402FR-074K02L | Yageo | - | C137968 | 4.02K | 3 | 15 | 100 | LCSC (https://www.lcsc.com/product-detail/Chip-Resistor-Surface-Mount_YAGEO-RC0402FR-074K02L_C137968.html) | $0.0007 | $0.0700
34 | Resistor | R32, R33 | RES 2.7K OHM 1% 1/10W 0603 | Res-0603 | RC0603FR-072K7L | Yageo | - | C114612 | 2.7K | 2 | 10 | 100 | LCSC (https://www.lcsc.com/product-detail/Chip-Resistor-Surface-Mount_YAGEO-RC0603FR-072K7L_C114612.html) | $0.0012 | $0.1200
35 | Resistor | R34, R35, R56 | 100mW ±25ppm/℃ ±0.1% 2kΩ 0603 Chip Resistor - Surface Mount ROHS | Res-0603 | AR03BTCX2001 | Viking Tech | - | C318130 | 2K | 3 | 15 | 20 | LCSC (https://www.lcsc.com/product-detail/Chip-Resistor-Surface-Mount_Viking-Tech-AR03BTCX2001_C318130.html) | $0.0272 | $0.5440
36 | Resistor | R36, R37 | RES SMD 1.6K OHM 0.1% 1/16W 0402 | Res-0402 | RT0402BRD071K6L | Yageo | - | C852616 | 1.6K | 2 | 10 | 20 | LCSC (https://www.lcsc.com/product-detail/Chip-Resistor-Surface-Mount_YAGEO-RT0402BRD071K6L_C852616.html) | $0.0249 | $0.4980
37 | Resistor | R38, R39, R57 | 100mW ±25ppm/℃ ±0.1% 1.3kΩ 0603 Chip Resistor - Surface Mount ROHS | Res-0603 | AR03BTCX1301 | Viking Tech | - | C2984321 | 1.3K | 3 | 15 | 20 | LCSC (https://www.lcsc.com/product-detail/Chip-Resistor-Surface-Mount_Viking-Tech-AR03BTCX1301_C2984321.html) | $0.0302 | $0.6040
38 | Resistor | R40, R41 | RES SMD 1.1K OHM 0.1% 1/10W 0603 | Res-0603 | RT0603BRD071K1L | Yageo | - | C705736 | 1.1K | 2 | 10 | 20 | LCSC (https://www.lcsc.com/product-detail/Chip-Resistor-Surface-Mount_YAGEO-RT0603BRD071K1L_C705736.html) | $0.0278 | $0.5560
39 | Resistor | R44, R45 | 125mW Thin Film Resistor 150V ±25ppm/℃ ±0.1% -55℃~+155℃ 900Ω 0805 Chip Resistor - Surface Mount ROHS | RES-0805 | ARG05BTC9000N | Viking Tech | - | C2828704 | 900R | 2 | 10 | 20 | LCSC (https://www.lcsc.com/product-detail/Chip-Resistor-Surface-Mount_Viking-Tech-ARG05BTC9000N_C2828704.html) | $0.0324 | $0.6480
40 | Resistor | R46, R47, R59 | RES SMD 806 OHM 0.1% 1/16W 0402 | Res-0402 | RT0402BRD07806RL | Yageo | - | C852922 | 806R | 3 | 15 | 20 | LCSC (https://www.lcsc.com/product-detail/Chip-Resistor-Surface-Mount_YAGEO-RT0402BRD07806RL_C852922.html) | $0.0258 | $0.5160
41 | Resistor | R51 | RES SMD 13.3KOHM 0.1% 1/10W 0603 | Res-0603 | RT0603BRD0713K3L | Yageo | - | C861117 | 13.3K | 1 | 5 | 20 | LCSC (https://www.lcsc.com/product-detail/Chip-Resistor-Surface-Mount_YAGEO-RT0603BRD0713K3L_C861117.html) | $0.0294 | $0.5880
42 | Resistor | R54 | 125mW Thick Film Resistors 150V ±100ppm/℃ ±1% -55℃~+155℃ 98kΩ 0805 Chip Resistor - Surface Mount ROHS | RES-0805 | FRC0805F9802TS | FOJAN | - | C2933514 | 98K | 1 | 5 | 100 | LCSC (https://www.lcsc.com/product-detail/Chip-Resistor-Surface-Mount_FOJAN-FRC0805F9802TS_C2933514.html) | $0.0019 | $0.1900
43 | Resistor | R60 | RES SMD 649 OHM 0.1% 1/8W 0805 | RES-0805 | RT0805BRD07649RL | Yageo | - | C865602 | 649R | 1 | 5 | 20 | LCSC (https://www.lcsc.com/product-detail/Chip-Resistor-Surface-Mount_YAGEO-RT0805BRD07649RL_C865602.html) | $0.0386 | $0.7720
44 | Resistor | R61 | 62.5mW Thin Film Resistor 50V ±25ppm/℃ ±0.1% -55℃~+155℃ 549Ω 0402 Chip Resistor - Surface Mount ROHS | Res-0402 | ARG02BTC5490 | Viking Tech | - | C2684524 | 549R | 1 | 5 | 20 | LCSC (https://www.lcsc.com/product-detail/Chip-Resistor-Surface-Mount_Viking-Tech-ARG02BTC5490_C2684524.html) | $0.0217 | $0.4340
45 | Resistor | R62 | 125mW Thin Film Resistor 150V ±25ppm/℃ ±0.1% -55℃~+155℃ 500Ω 0805 Chip Resistor - Surface Mount ROHS | RES-0805 | ARG05BTC5000 | Viking Tech | - | C2828711 | 500R | 1 | 5 | 20 | LCSC (https://www.lcsc.com/product-detail/Chip-Resistor-Surface-Mount_Viking-Tech-ARG05BTC5000_C2828711.html) | $0.0312 | $0.6240
46 | Resistor | R63 | RES SMD 453 OHM 0.1% 1/16W 0402 | Res-0402 | RT0402BRD07453RL | Yageo | - | C852794 | 453R | 1 | 5 | 20 | LCSC (https://www.lcsc.com/product-detail/Chip-Resistor-Surface-Mount_YAGEO-RT0402BRD07453RL_C852794.html) | $0.0252 | $0.5040
47 | Resistor | R64 | 100mW Thin Film Resistor 75V ±25ppm/℃ ±0.1% -55℃~+155℃ 402Ω 0603 Chip Resistor - Surface Mount ROHS | Res-0603 | ARG03BTC4020 | Viking Tech | - | C2683044 | 402R | 1 | 5 | 20 | LCSC (https://www.lcsc.com/product-detail/Chip-Resistor-Surface-Mount_Viking-Tech-ARG03BTC4020_C2683044.html) | $0.0237 | $0.4740
48 | Potentiometer | R67 | TRIMMER 100K OHM 0.1W J LEAD TOP | Custom | TC33X-2-104E | Bourns |  | C719186 | 100k | 1 | 5 | 10 | LCSC (https://www.lcsc.com/product-detail/Variable-Resistors-Potentiometers_BOURNS-TC33X-2-104E_C719186.html) | $0.1440 | $1.4400
49 | Resistor | R71, R72 | RES SMD 47K OHM 0.1% 1/10W 0603 | Res-0603 | RT0603BRD0747KL | Yageo | - | C326725 | 47K | 2 | 10 | 20 | LCSC (https://www.lcsc.com/product-detail/Chip-Resistor-Surface-Mount_YAGEO-RT0603BRD0747KL_C326725.html) | $0.0254 | $0.5080
50 | Solder Bridge | ~~SB1, SB2~~ | ~~Solder Bridge ON~~ | ~~Custom~~ | ~~Solder Bridge~~ | ~~-~~ | - | ~~-~~ | ~~-~~ | ~~2~~ | ~~10~~ | ~~-~~ | ~~-~~ | ~~-~~ | ~~-~~
51 | Switch | SW1, SW2, SW3, SW4, SW5, SW6, SW7, SW8, SW9 | Gull Wing SPST 24V 25mA Black -20℃~+70℃ 3000 Flat dial, raised type 2.54mm 5 SMD-10P,6x12.6mm DIP Switches ROHS | Custom | DSIC05LS-P | XKB Connectivity | - | C319036 | - | 9 | 45 | 47 | LCSC (https://www.lcsc.com/product-detail/DIP-Switches_XKB-Connectivity-DSIC05LS-P_C319036.html) | $0.4646 | $21.8362
52 | IC | U1, U2, U3 | General Purpose Amplifier 2 Circuit 8-SO | SOIC-8 | LM2904DT | STMicroelectronics | - | C105411 | - | 3 | 15 | 20 | LCSC (https://www.lcsc.com/product-detail/Operational-Amplifier_STMicroelectronics-LM2904DT_C105411.html) | $0.1139 | $2.2780
 |  |  |  |  |  |  |  |  |  |  |  | Total Component Cost |  |  | $65.76
 |  |  |  |  |  |  |  |  |  |  |  | Single Board Cost |  |  | $13.15
