eSpark-Consulting-Group/xponent-tech-sleep-enhancer-hw/Design Files/Xponent-tech/Deliverables/Supporting_files/Microphone Breakout Board.step

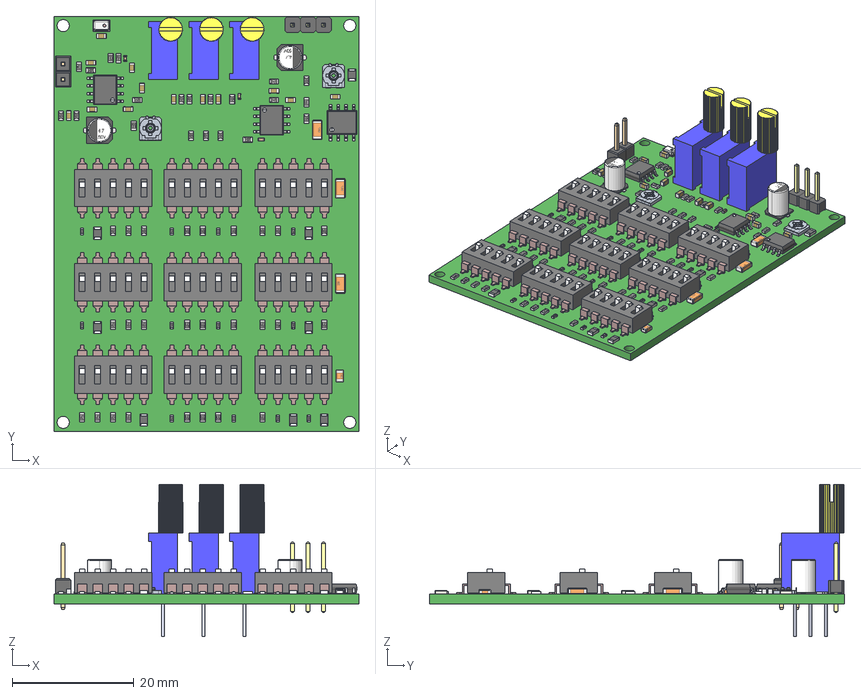
[picture p1: CAD file, 2023-03-29]
Design Files/Xponent-tech/Deliverables/Supporting_files/Microphone Breakout Board.step
50.0 x 68.1 x 25.0 mm
User_Library-RES_1005-0402 x 12
3926w x 3
User_Library-SOIC-8-1 x 3
DSIC05LS-P x 9
User_Library-RESC1608X05N x 47
TC33_SUBST1 x 2
User_Library-CR2012-0805 x 8
ZTS6117
User_Library-Header_Male_3Pin_PinArray
User_Library-Header_Male_3Pin_BodyArray
User_Library-Header1x2_Header1_1 x 2
User_Library-CAPC1608X09 x 13
User_Library-Capacitor_0402 x 3
User_Library-1206_SMD_Capacitor x 3
User_Library-4x5_4 x 2
User_Library-0805_SMD_Capacitor
