eSpark-Consulting-Group/xponent-tech-sleep-enhancer-hw/(list of files, cad)

Other CAD files:
Design Files/Xponent-tech/Deliverables/Supporting_files/Microphone Breakout Board.DWG
Design Files/Xponent-tech/Deliverables/Supporting_files/Microphone Breakout Board.DXF
