eSpark-Consulting-Group/xponent-tech-sleep-enhancer-hw/Design Files/Xponent-tech/Deliverables/Schematics/Assembly_drawing.pdf

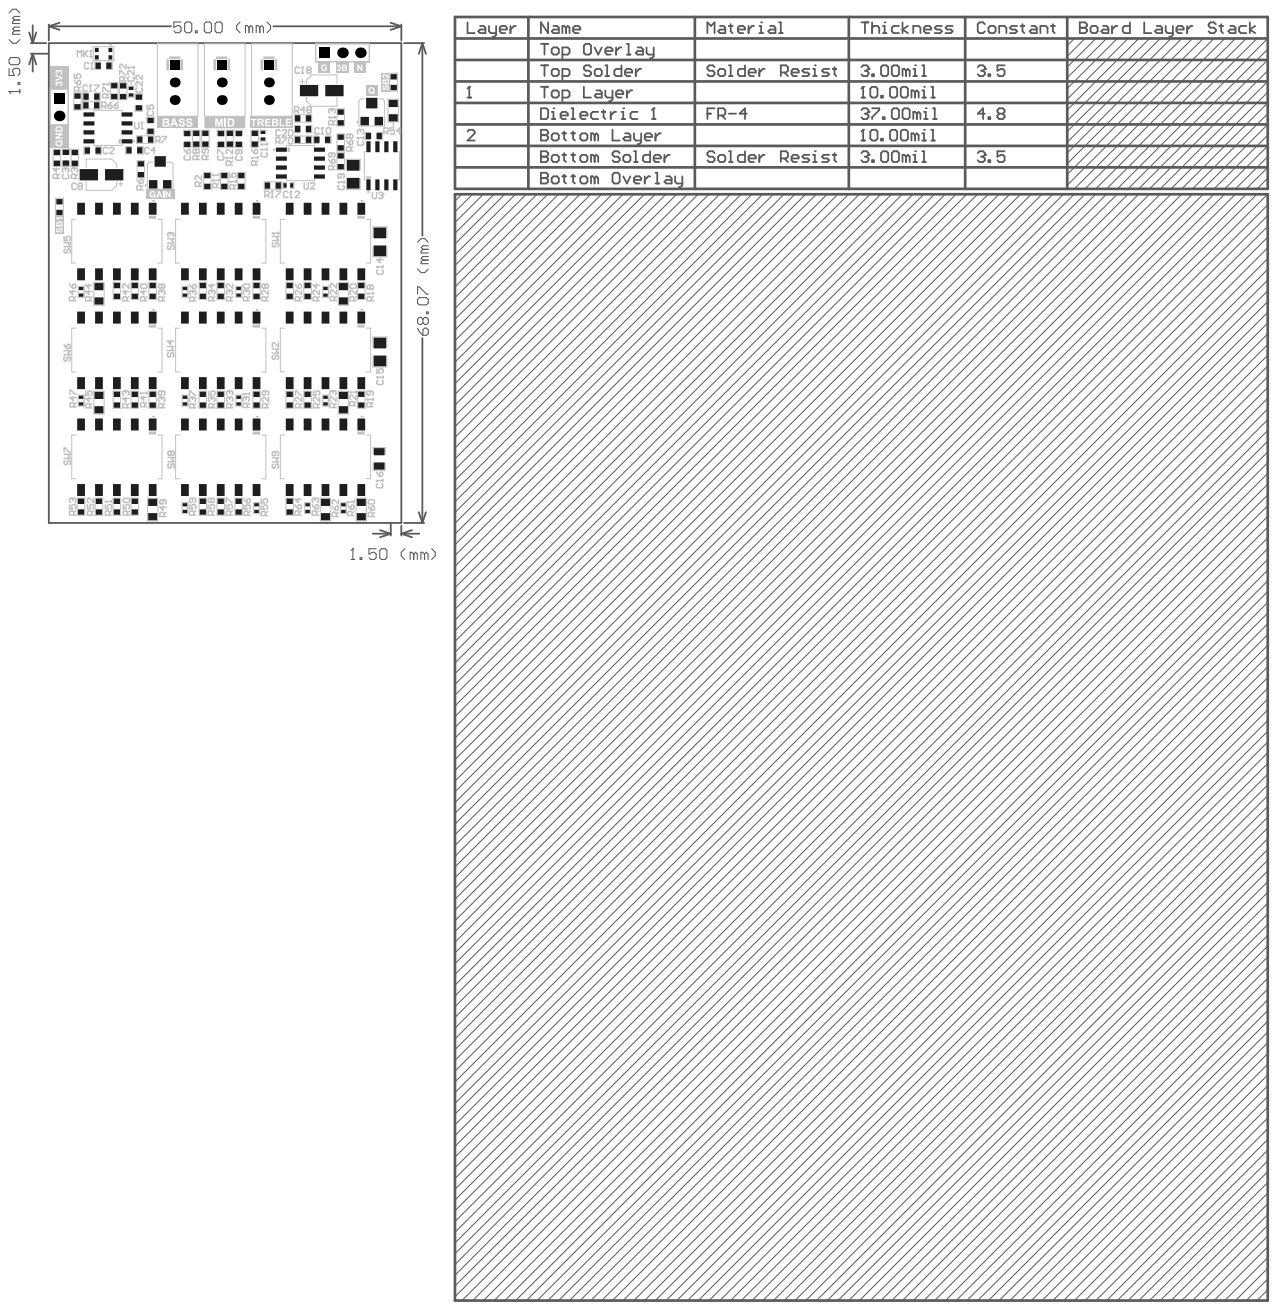
[picture p2: page 1]

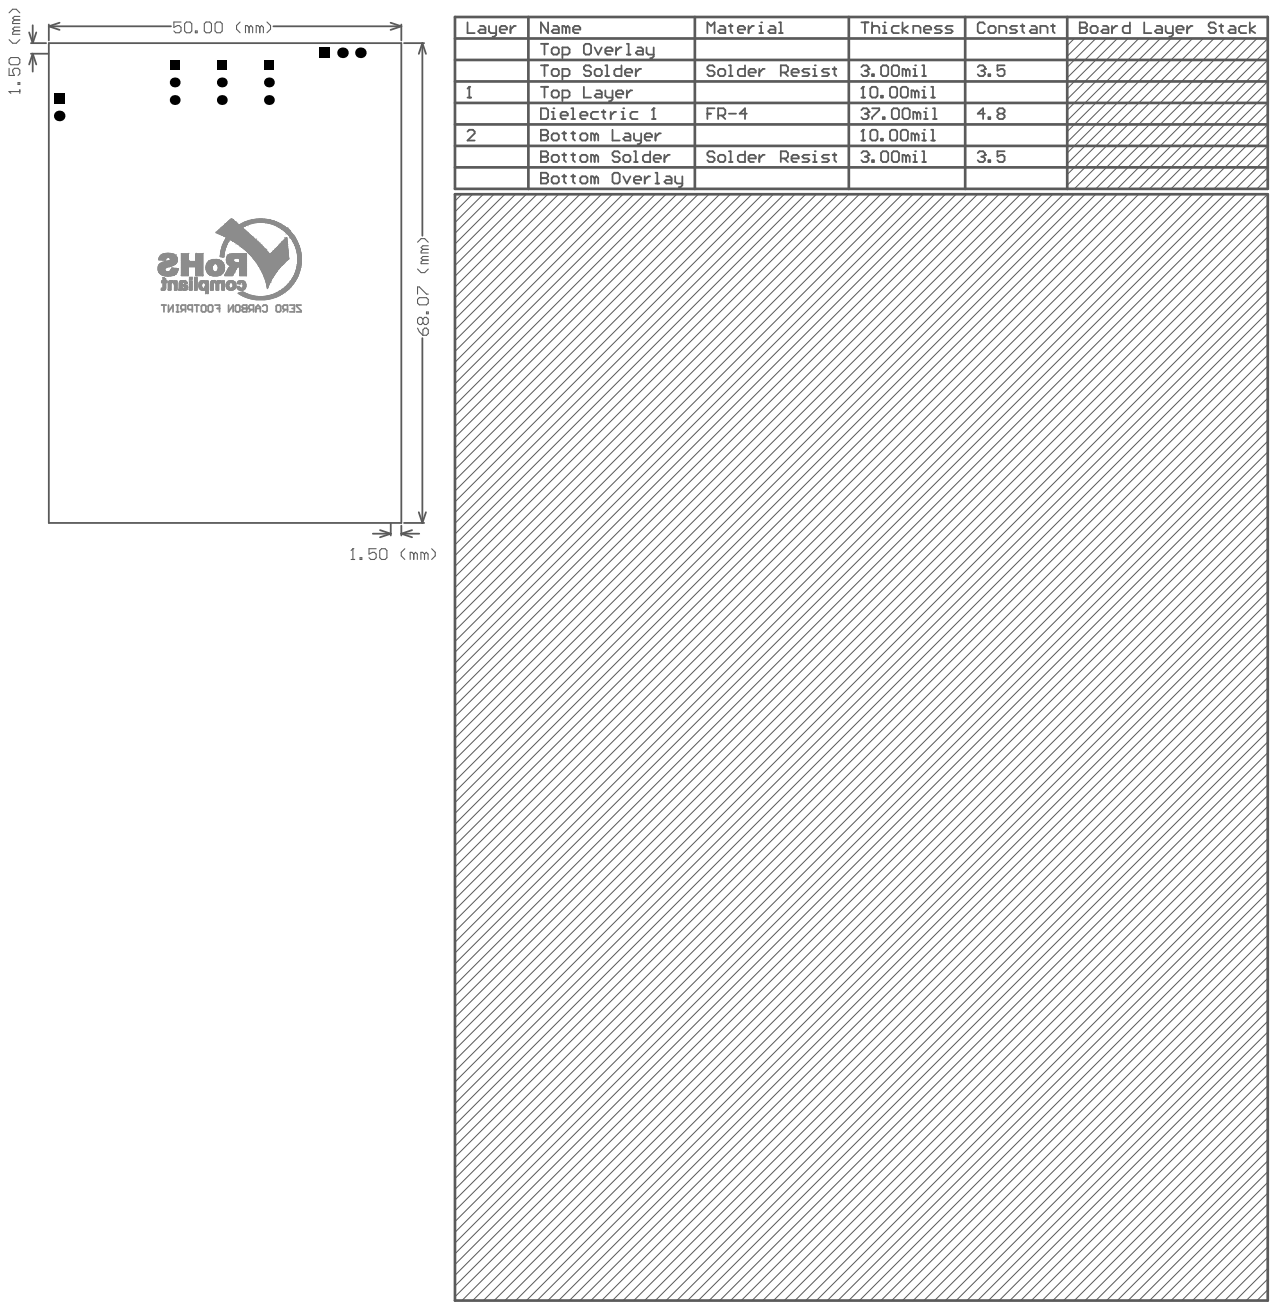
[picture p3: page 2]
