eSpark-Consulting-Group/xponent-tech-sleep-enhancer-hw/Design Files/Xponent-tech/Deliverables/Schematics/Xponent-tech.pdf

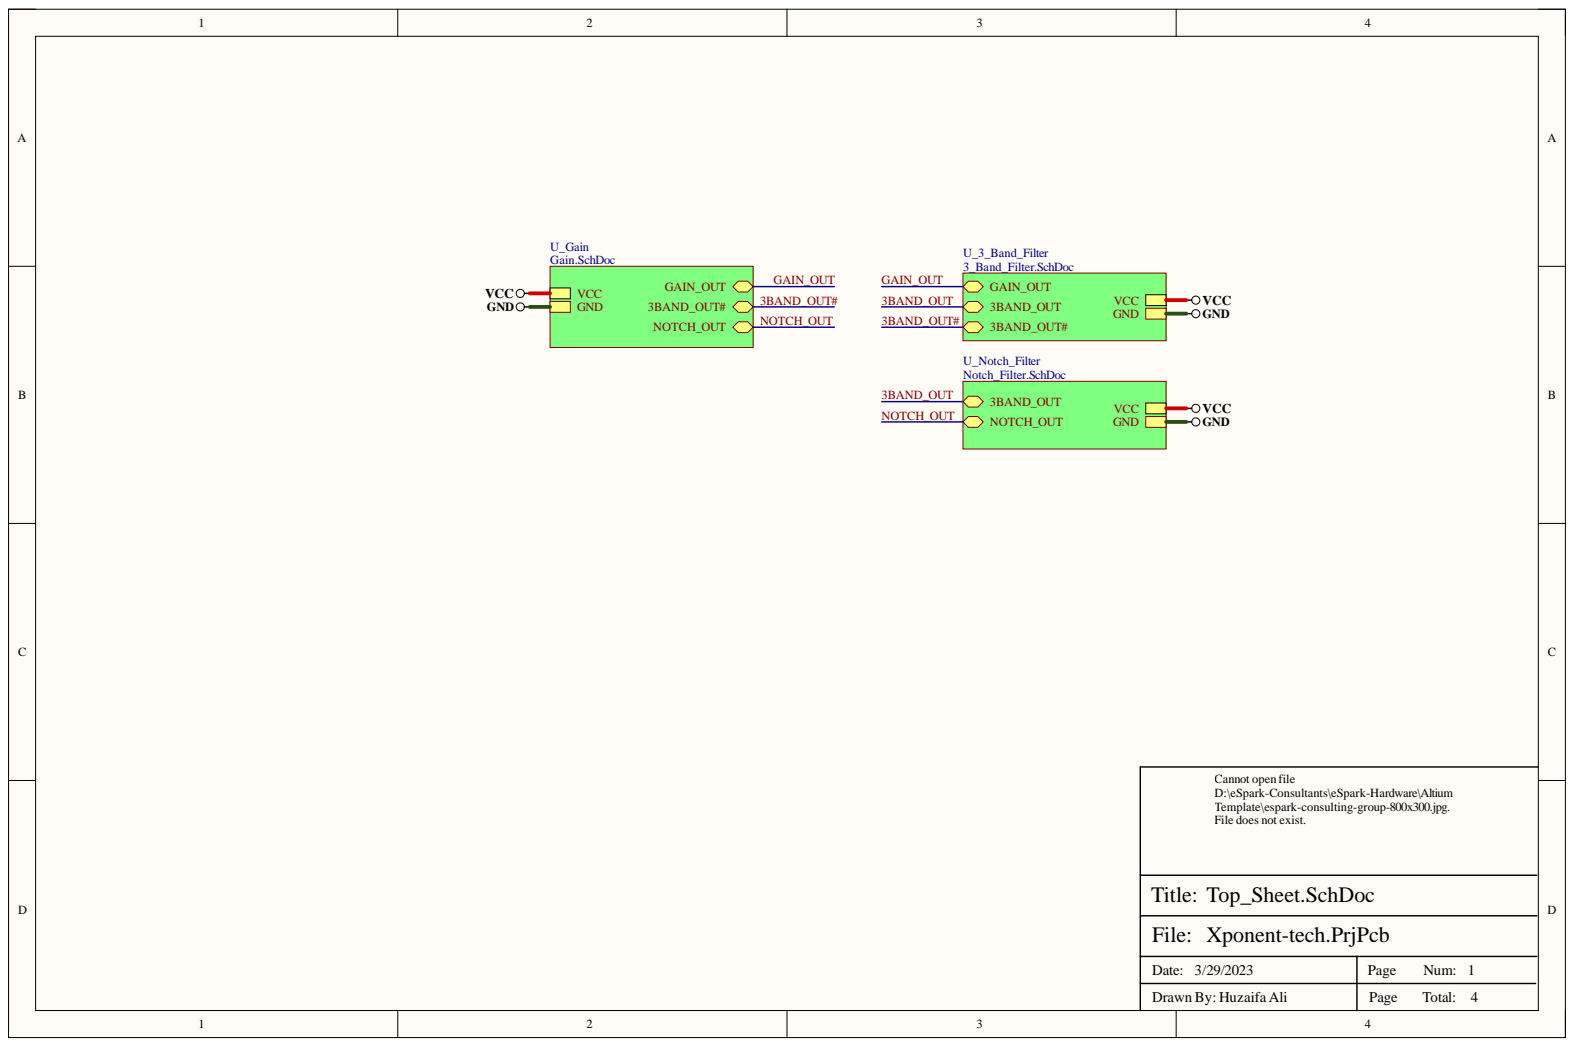
[picture p4: page 1]

GAIN_OUT 3BAND_OUT#

NOTCH_OUT

Cannot open file
D:\eSpark-Consultants\eSpark-Hardware\Altium
Template\espark-consulting-group-800x300.jpg.
File does not exist.

Date: 3/29/2023 | Page Num: 1

Drawn By: Huzaifa Ali | Page Total: 4

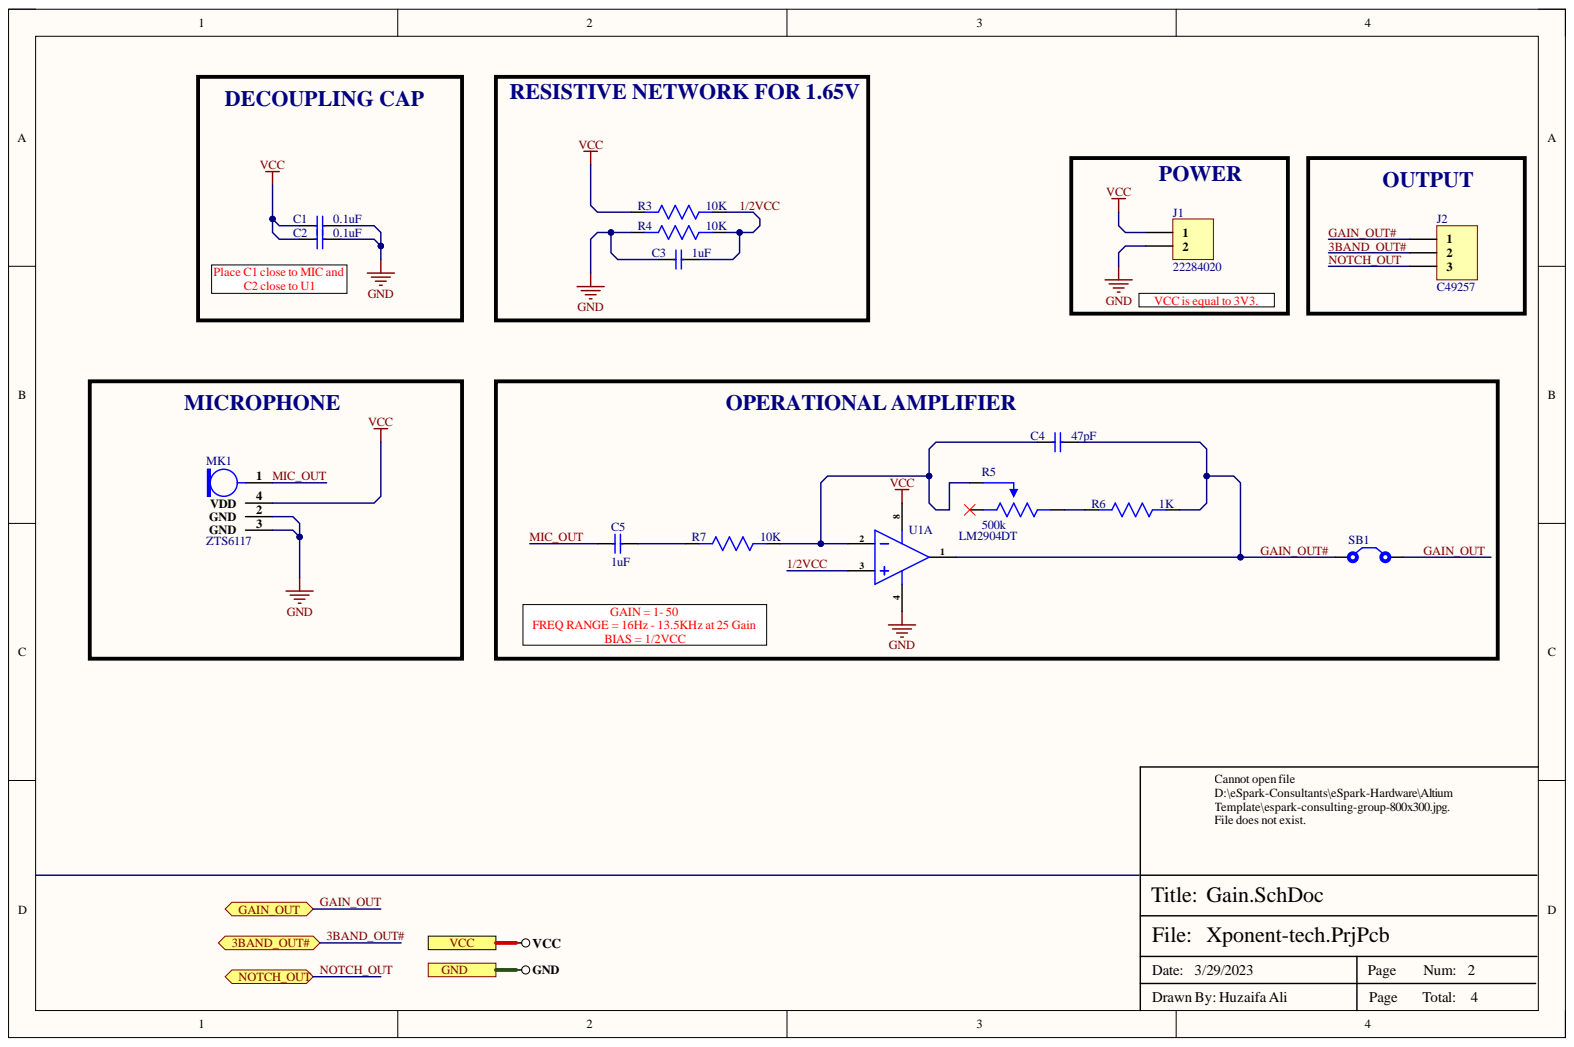
[picture p5: page 2]

Place C1 close to MIC and
C2 close to U1

VCC is equal to 3V3.

FREQ RANGE = 16Hz - 13.5KHz at 25 Gain

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

Date: 3/29/2023 | Page Num: 2

Drawn By: Huzaifa Ali | Page Total: 4

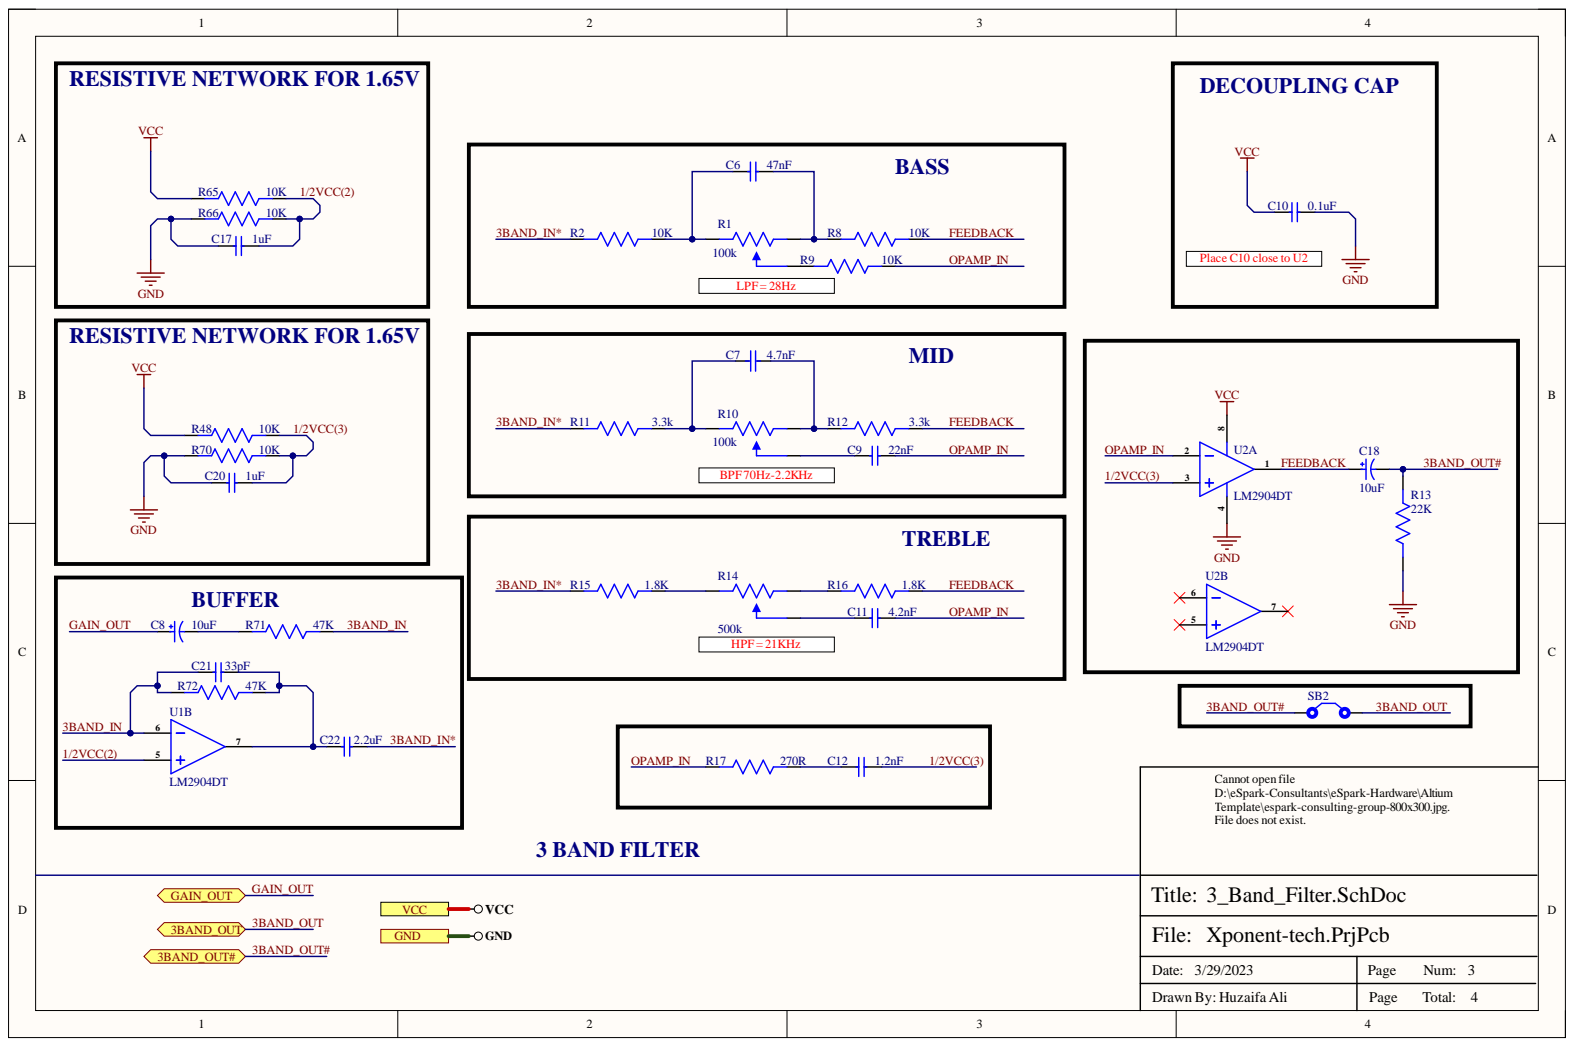
[picture p6: page 3]
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

Date: 3/29/2023 | Page Num: 3

Drawn By: Huzaifa Ali | Page Total: 4

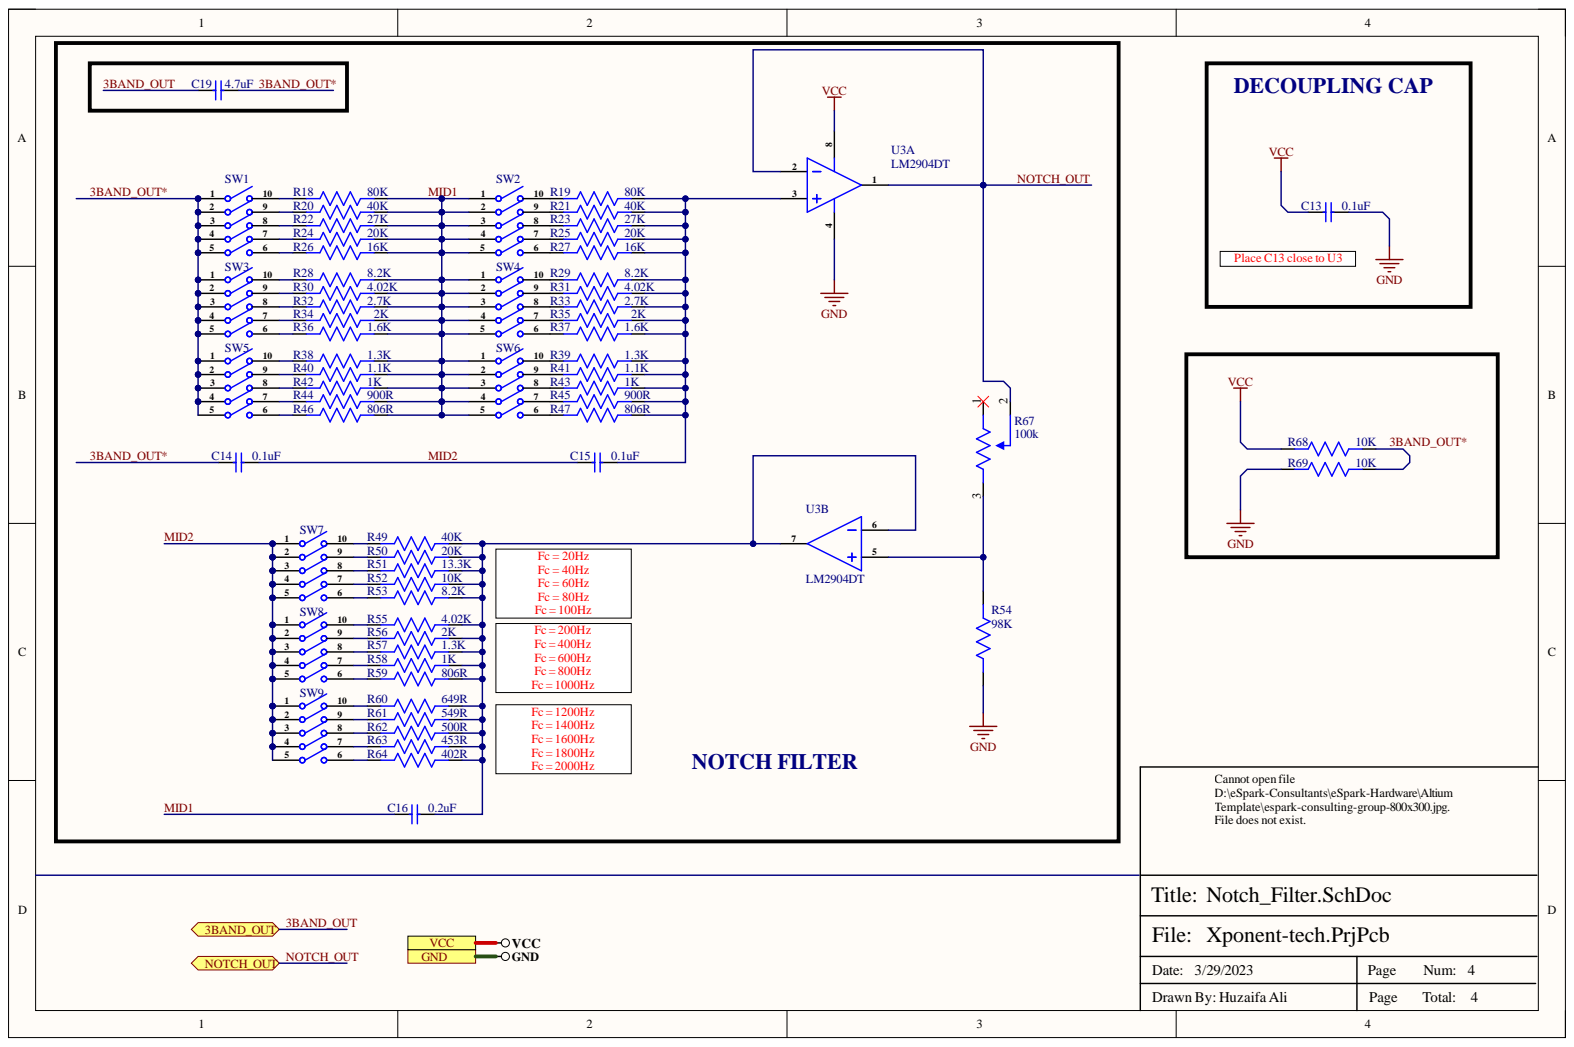
[picture p7: page 4]

DECOUPLING CAP Place C13 close to U3

Dat e : 3 / 2 9 / 2 0 2 3 | Pag e N u m : 44

D raw n B y : H uzai fa A l i | Pag e To t al :

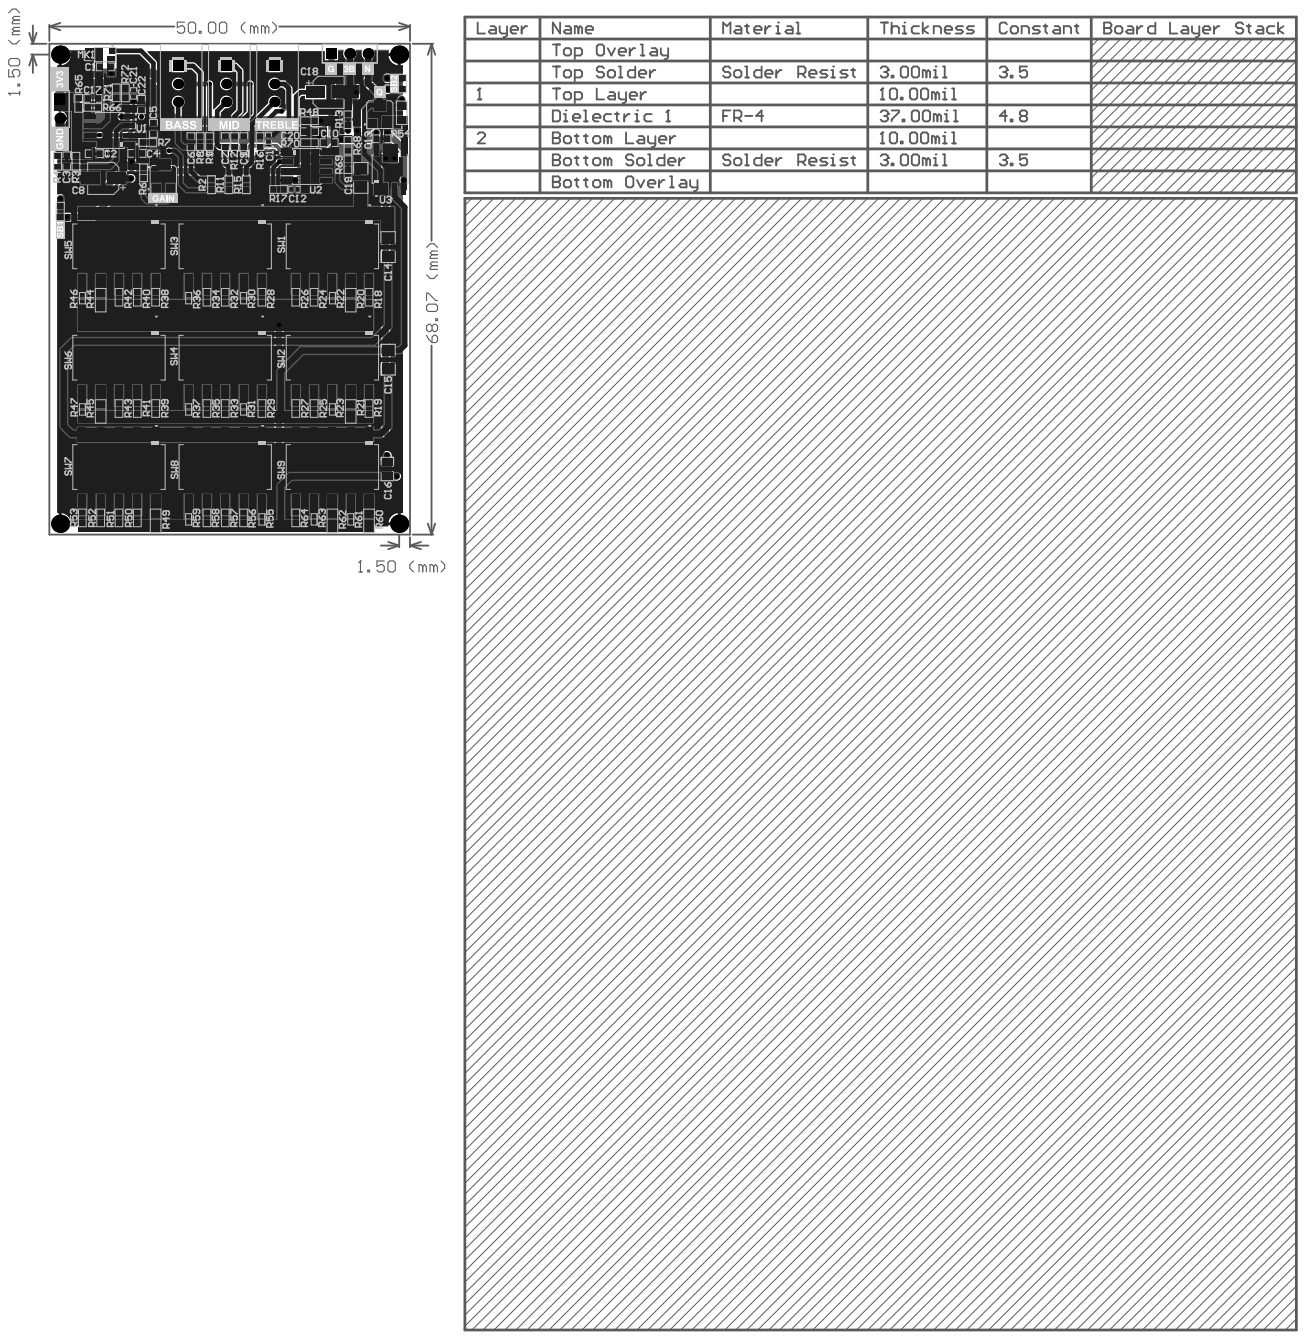
[picture p8: page 5]
