eSpark-Consulting-Group/xponent-tech-sleep-enhancer-hw/(list of files, drawings)

Other design files:
Design Files/Xponent-tech/3_Band_Filter.SchDoc
Design Files/Xponent-tech/Gain.SchDoc
Design Files/Xponent-tech/Microphone Breakout Board.PcbDoc
Design Files/Xponent-tech/Notch_Filter.SchDoc
Design Files/Xponent-tech/Top_Sheet.SchDoc
Design Files/Xponent-tech/Xponent-tech.PrjPcb
