eSpark-Consulting-Group/xponent-tech-sleep-enhancer-hw/(commit log)

2023-02-10 #2 Updated
    [Sheet1.SchDoc, Xponent-tech.PrjPcb]
2023-02-13 #2 Amplifier and Filter added
    [Sheet1.SchDoc]
2023-02-14 #2 MIC changed and RC values finalized
    [Sheet1.SchDoc]
2023-02-14 #2 Decoupling Capacitors added
    [Sheet1.SchDoc]
2023-02-15 #2 Added 3 band equalizer
    [3_Band_Filter.SchDoc, Gain.SchDoc, Notch_Filter.SchDoc, Sheet1.SchDoc, Xponent-tech.PrjPcb]
2023-02-16 #2 Completed
    [3_Band_Filter.SchDoc, Gain.SchDoc, Notch_Filter.SchDoc, OLD_3_Band_Filter.SchDoc, Xponent-tech.PrjPcb]
2023-02-17 #2 Library for components
    [xponent.PcbLib, xponent.SchLib]
2023-02-17 #2 Added all ports and top sheet
    [3_Band_Filter.SchDoc, Gain.SchDoc, Notch_Filter.SchDoc, Top_Sheet.SchDoc, Xponent-tech.PrjPcb, xponent.PcbLib]
2023-02-17 #2 Footprint added
    [3_Band_Filter.SchDoc, xponent.PcbLib]
2023-02-17 #2 Step file updated
    [xponent.PcbLib]
2023-02-20 #2 Library updated
    [xponent.PcbLib, xponent.SchLib]
2023-02-20 #2 components library changed to centralized
    [3_Band_Filter.SchDoc, Gain.SchDoc, Notch_Filter.SchDoc, Top_Sheet.SchDoc]
2023-03-06 #5 Updated
    [3_Band_Filter.SchDoc, Gain.SchDoc, Notch_Filter.SchDoc, Top_Sheet.SchDoc, xponent.PcbLib, xponent.SchLib]
2023-03-06 #5 Library added
    [xponent.SchLib]
2023-03-06 #5 C4 replaced
    [Gain.SchDoc]
2023-03-09 #6 Placement in progress
    [3_Band_Filter.SchDoc, Gain.SchDoc, Microphone Breakout Board.PcbDoc, Notch_Filter.SchDoc, Xponent-tech.PrjPcb]
2023-03-09 #6 Design Completed
    [Microphone Breakout Board.PcbDoc, Xponent-tech.PrjPcb]
2023-03-09 #7 BOM Completed
    [Client-BOM-Xponent-tech.xlsx, JLCPCB-BOM-Xponent-tech.xlsx, eSpark-BOM-Xponent-tech.xlsx]
2023-03-10 #7 1 Board BOM Price Update
    [eSpark-BOM-Xponent-tech.xlsx]
2023-03-13 #8 Modification in progress
    [Microphone Breakout Board.PcbDoc]
2023-03-13 #5 Library updated
    [xponent.PcbLib, xponent.SchLib]
2023-03-13 #5 #8 R1, R10, R14 Potentiometers Replaced
    [3_Band_Filter.SchDoc, Gain.SchDoc, Xponent-tech.PrjPcb]
2023-03-13 #8 Modifications Completed
    [3_Band_Filter.SchDoc, Gain.SchDoc, Microphone Breakout Board.PcbDoc, Notch_Filter.SchDoc, Xponent-tech.PrjPcb]
2023-03-13 #7 Updated File
    [eSpark-BOM-Xponent-tech.xlsx]
2023-03-13 #8 Done.
    [3_Band_Filter.SchDoc, Gain.SchDoc, Microphone Breakout Board.PcbDoc, Notch_Filter.SchDoc, Top_Sheet.SchDoc]
2023-03-13 #9 Done.
    [3_Band_Filter.SchDoc, Centroid File.csv, Gain.SchDoc, Microphone Breakout Board.DWG, Microphone Breakout Board.DXF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]
2023-03-14 #7 BOM Updated
    [Client-BOM-Xponent-tech.xlsx, JLCPCB-BOM-Xponent-tech.xlsx, eSpark-BOM-Xponent-tech.xlsx]
2023-03-14 Library files removed
    [xponent.PcbLib, xponent.SchLib]
2023-03-14 PDF generated; forwarded to client
    [3_Band_Filter.SchDoc, Gain.SchDoc, Microphone Breakout Board.PcbDoc, Notch_Filter.SchDoc, Top_Sheet.SchDoc, Xponent-tech.PrjPcb]
2023-03-14 #7 Component Price added in Client BOM
    [Client-BOM-Xponent-tech.xlsx, eSpark-BOM-Xponent-tech.xlsx]
2023-03-14 #7 Client BOM Price Edit
    [Client-BOM-Xponent-tech.xlsx]
2023-03-15 #6 Done.
    [3_Band_Filter.SchDoc, Gain.SchDoc, Microphone Breakout Board.PcbDoc, Notch_Filter.SchDoc, Top_Sheet.SchDoc, Xponent-tech.PrjPcb]
2023-03-15 #9 Fresh Deliverables Done.
    [3_Band_Filter.SchDoc, Centroid File.csv, Gain.SchDoc, Microphone Breakout Board.DWG, Microphone Breakout Board.DXF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]
2023-03-17 #7 Item Type Added
    [Client-BOM-Xponent-tech.xlsx, eSpark-BOM-Xponent-tech.xlsx]
2023-03-29 #9 Fresh Deliverables generated and placed in their respective folder
    [Centroid File.csv, Centroid.csv, Client-BOM-Xponent-tech.xlsx, JLCPCB-BOM-Xponent-tech.xlsx, Microphone Breakout Board.DWG, Microphone Breakout Board.DXF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]
2023-03-29 deliverables folder removed
    [Centroid.csv, Client-BOM-Xponent-tech.xlsx, JLCPCB-BOM-Xponent-tech.xlsx, Microphone Breakout Board.DWG, Microphone Breakout Board.DXF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]
